CAD-Weazle/Charge-Shuttling-BMS/pics/110-BMS_test-setup.png

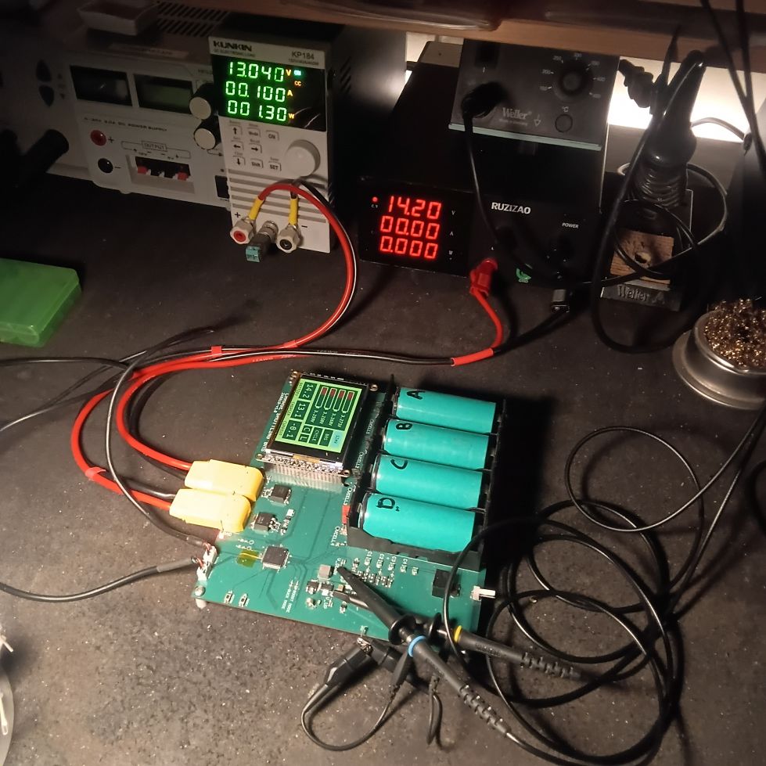
pics/110-BMS_test-setup.png
