CAD-Weazle/Charge-Shuttling-BMS/pics/48-cycle-test.png

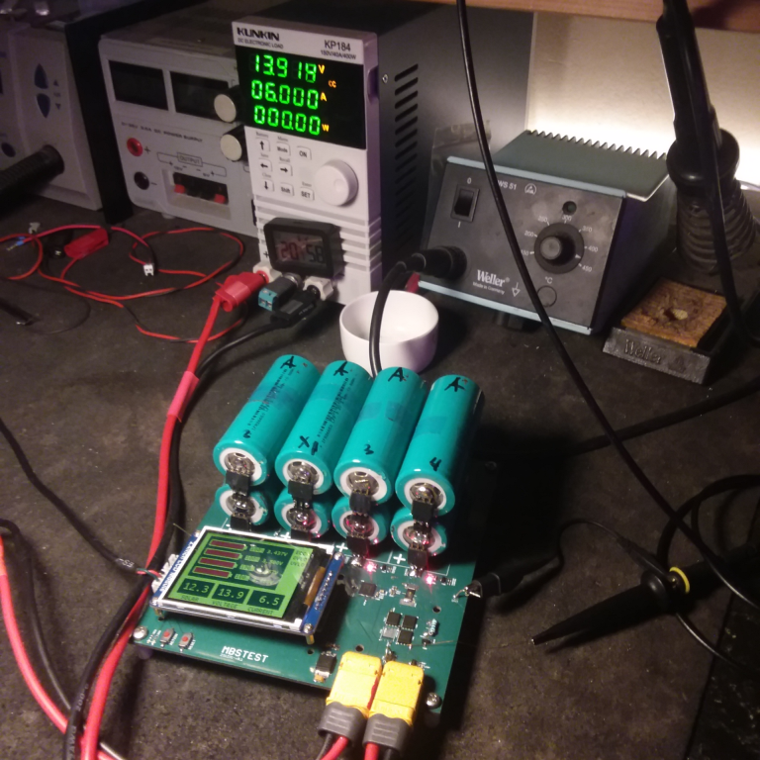
pics/48-cycle-test.png
