CAD-Weazle/Charge-Shuttling-BMS/ccode/readme.txt

Disclaimer

This project is provided "AS IS", without warranty of any kind, express or implied.

Use this software at your own risk. The author is not responsible for any damages, 
data loss, or other issues resulting from the use of this software, to the extent 
permitted by applicable law.
