CAD-Weazle/Charge-Shuttling-BMS/pics/44-LCD.png

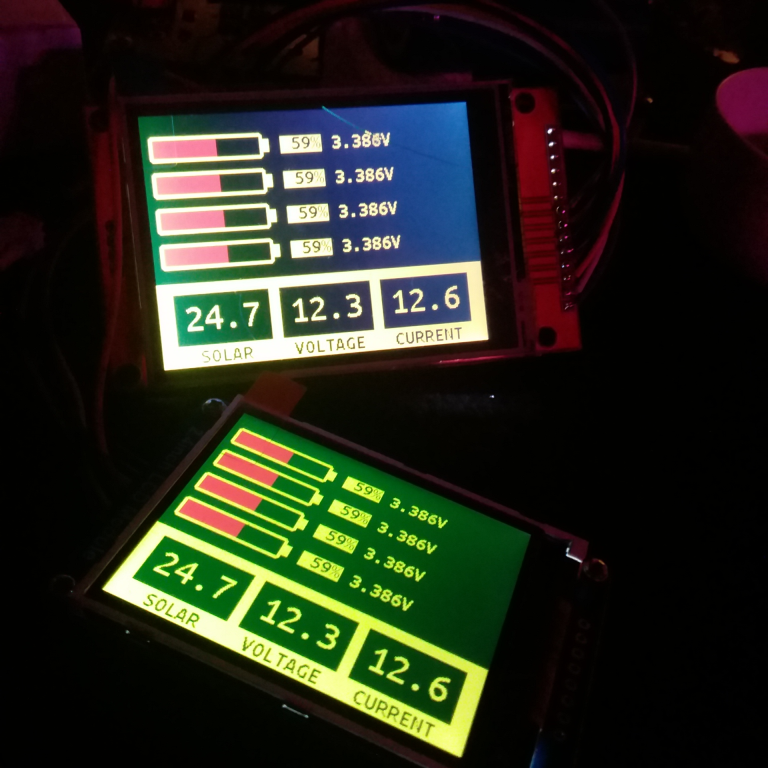
pics/44-LCD.png
