CAD-Weazle/Charge-Shuttling-BMS/pics/45-LCD.png

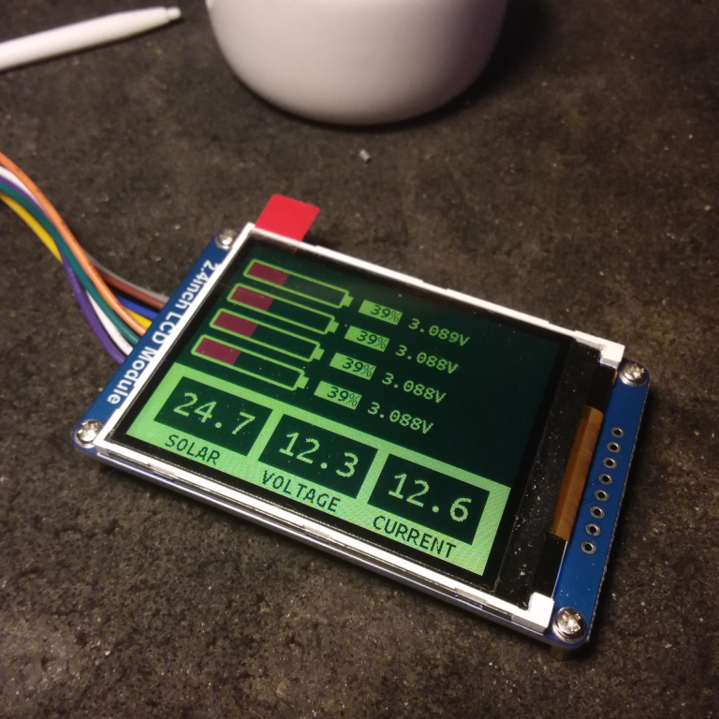
pics/45-LCD.png
