CAD-Weazle/Charge-Shuttling-BMS/pics/46-LCD-proto.png

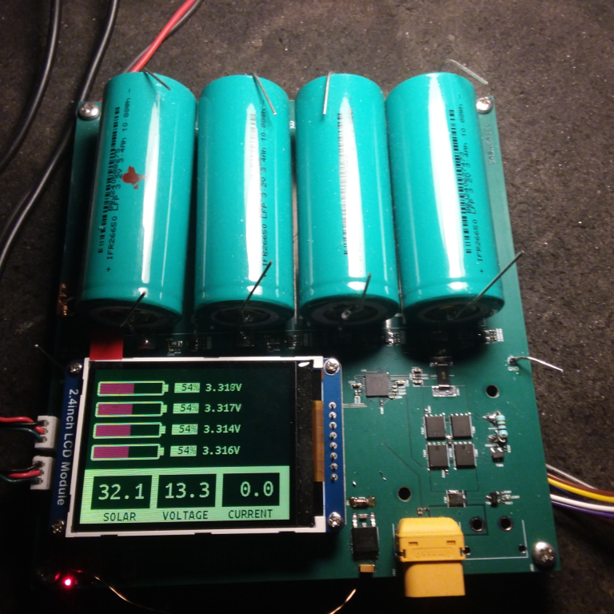
pics/46-LCD-proto.png
