CAD-Weazle/Charge-Shuttling-BMS/pics/47-V-vs-Q.png

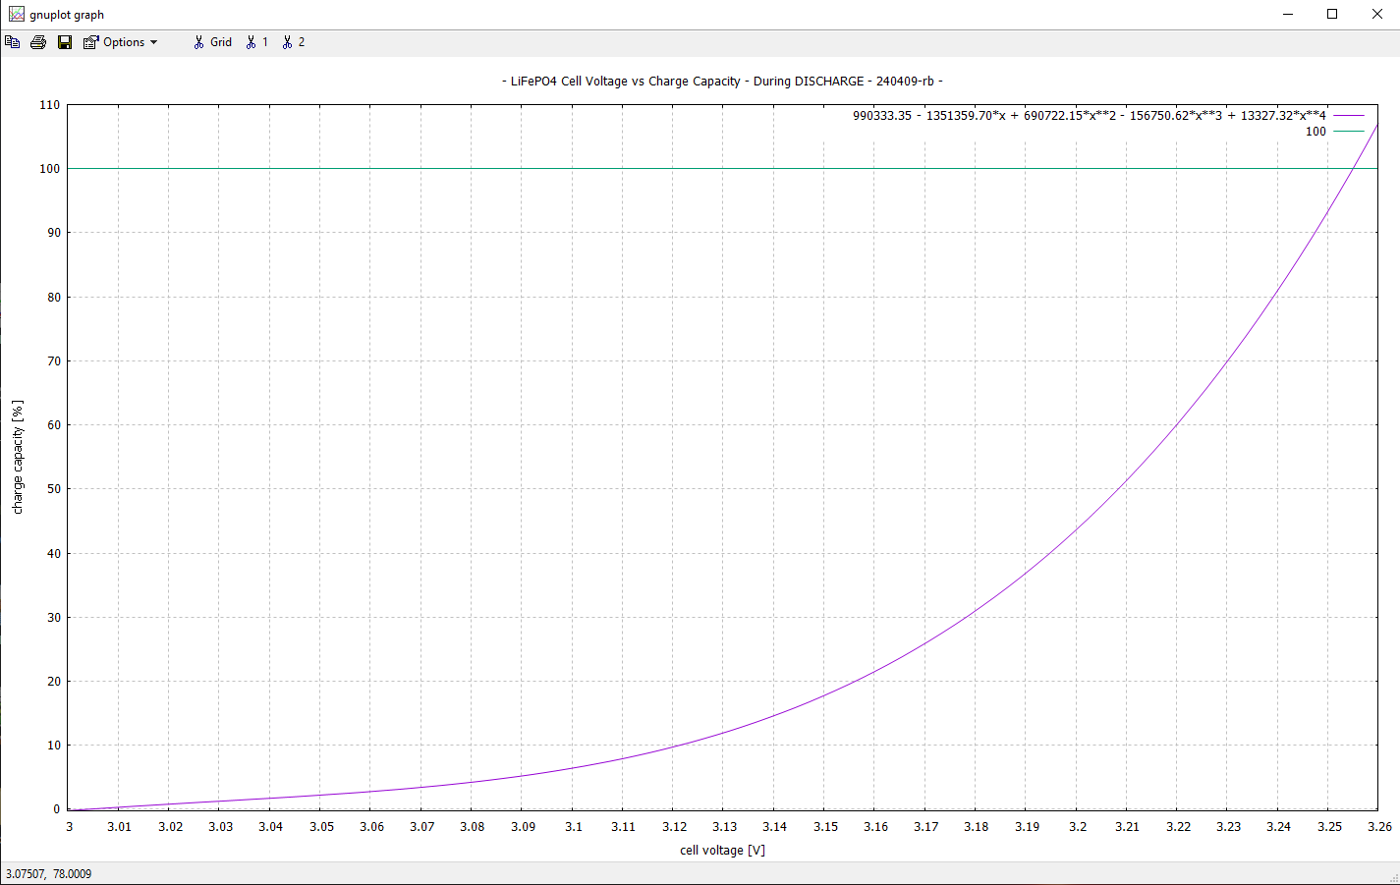
pics/47-V-vs-Q.png
