CAD-Weazle/Charge-Shuttling-BMS/pics/51-SOLBATTS.png

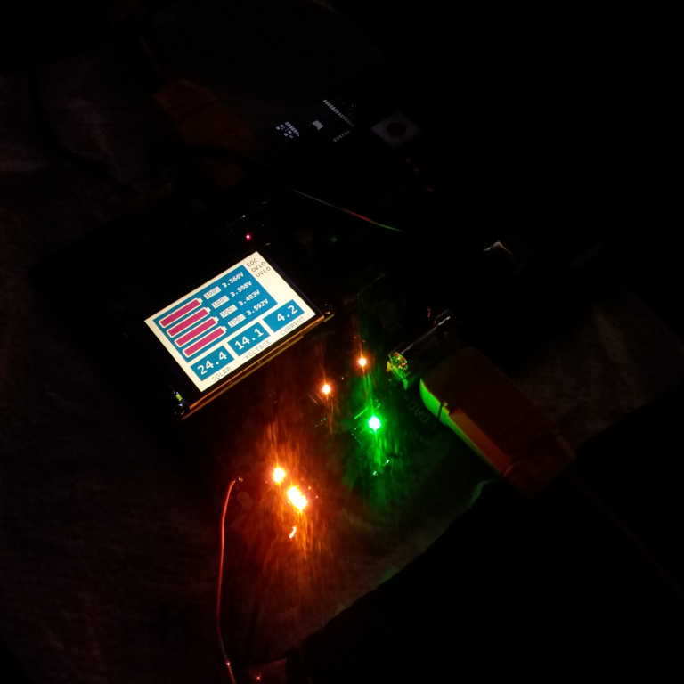
pics/51-SOLBATTS.png
