CAD-Weazle/Charge-Shuttling-BMS/pics/53-display.png

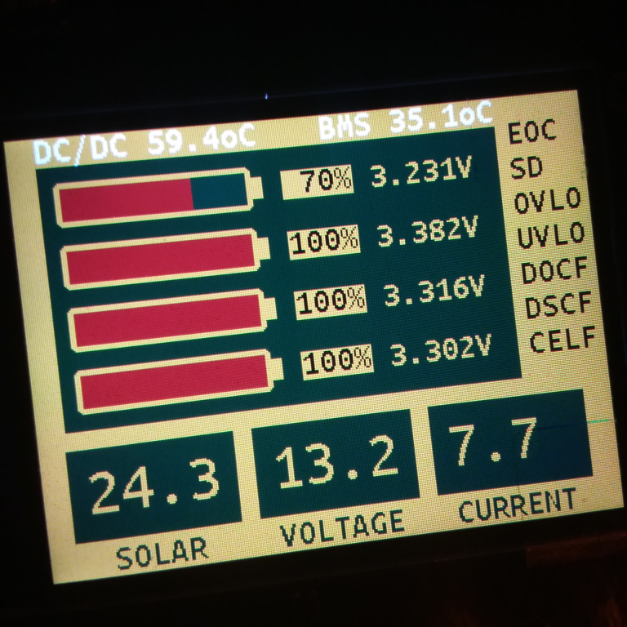
pics/53-display.png
