CAD-Weazle/Charge-Shuttling-BMS/pics/96-BMSTEST-charge-sharing.png

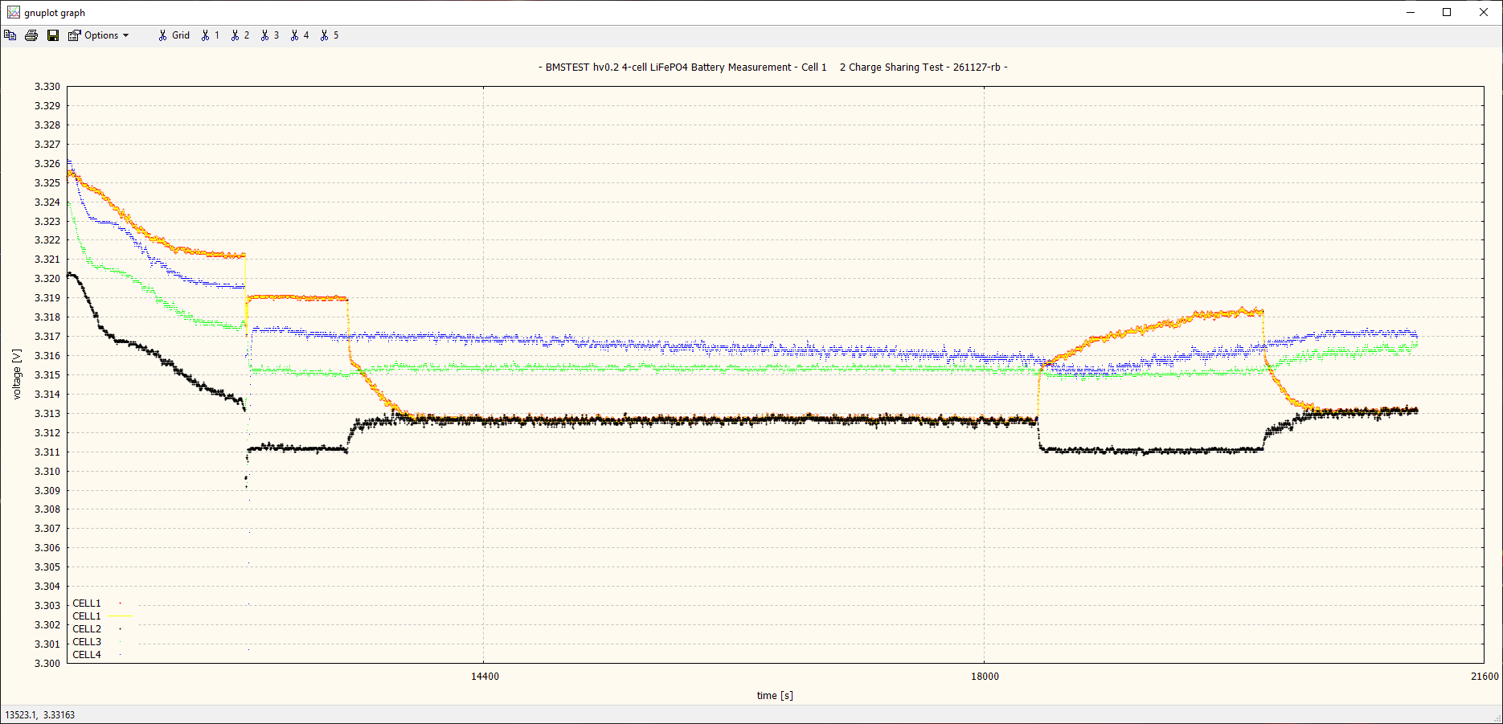
pics/96-BMSTEST-charge-sharing.png
