CAD-Weazle/Charge-Shuttling-BMS/pics/97-BMSTEST-charge-sharing.png

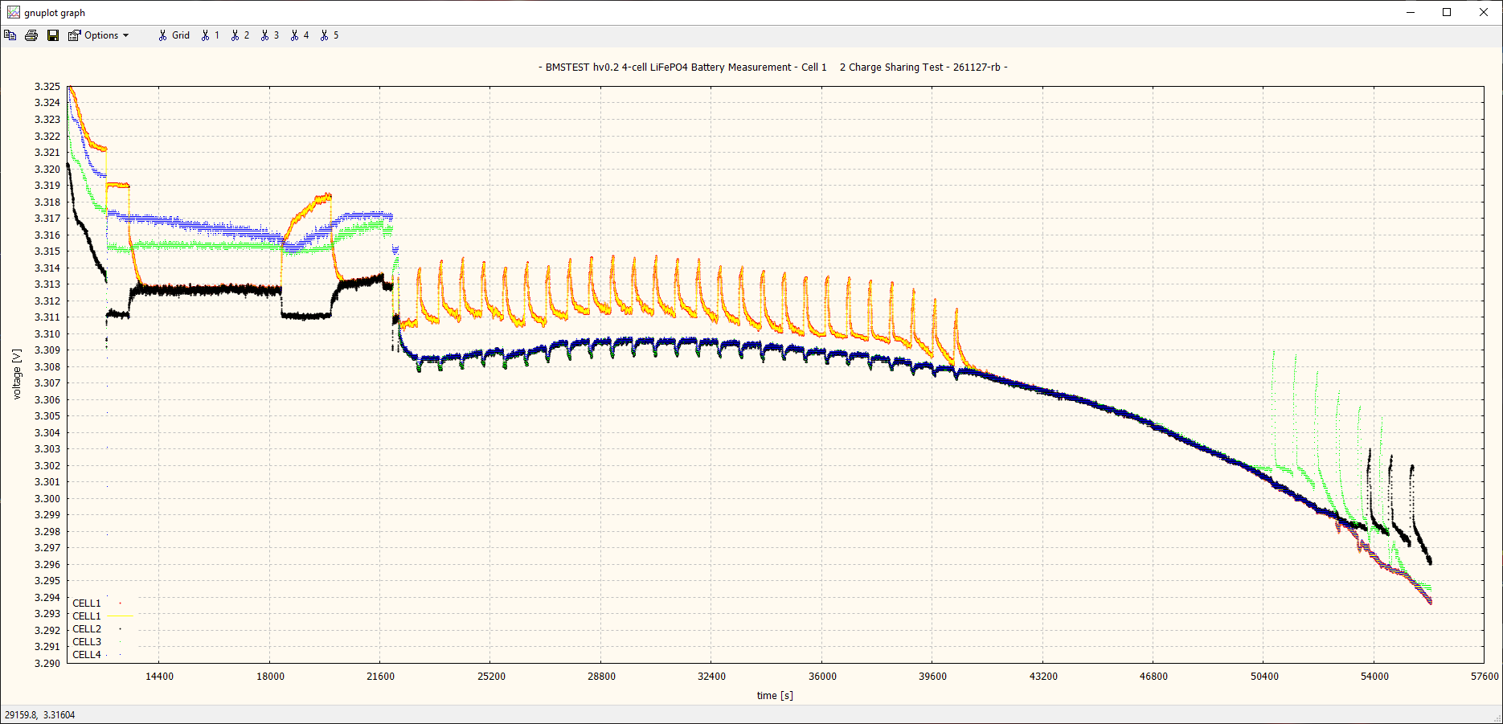
pics/97-BMSTEST-charge-sharing.png
