CAD-Weazle/Charge-Shuttling-BMS/pics/98-sharing-vs-normal.png

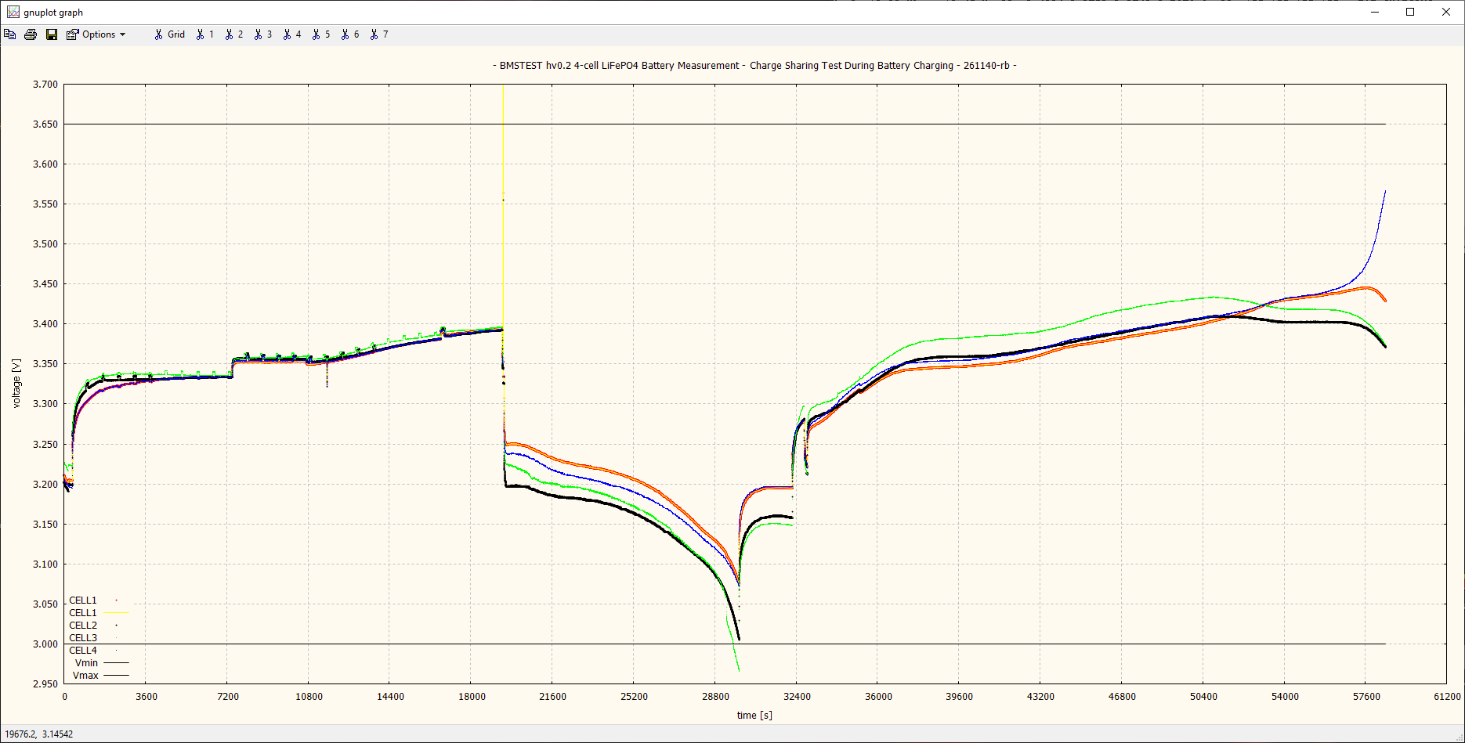
pics/98-sharing-vs-normal.png
