CAD-Weazle/Charge-Shuttling-BMS/pics/101-BMSTEST-hv0.3-PWM-noise.png

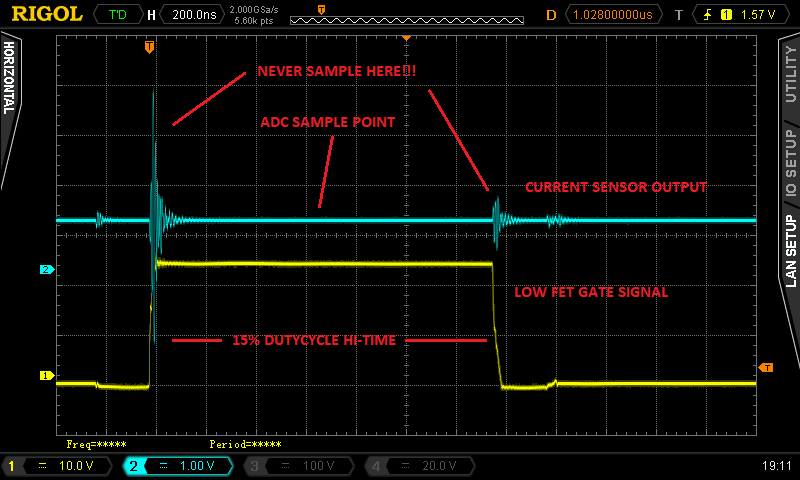
pics/101-BMSTEST-hv0.3-PWM-noise.png
