CAD-Weazle/Charge-Shuttling-BMS/pics/102-buck-boost_charge-transfer.png

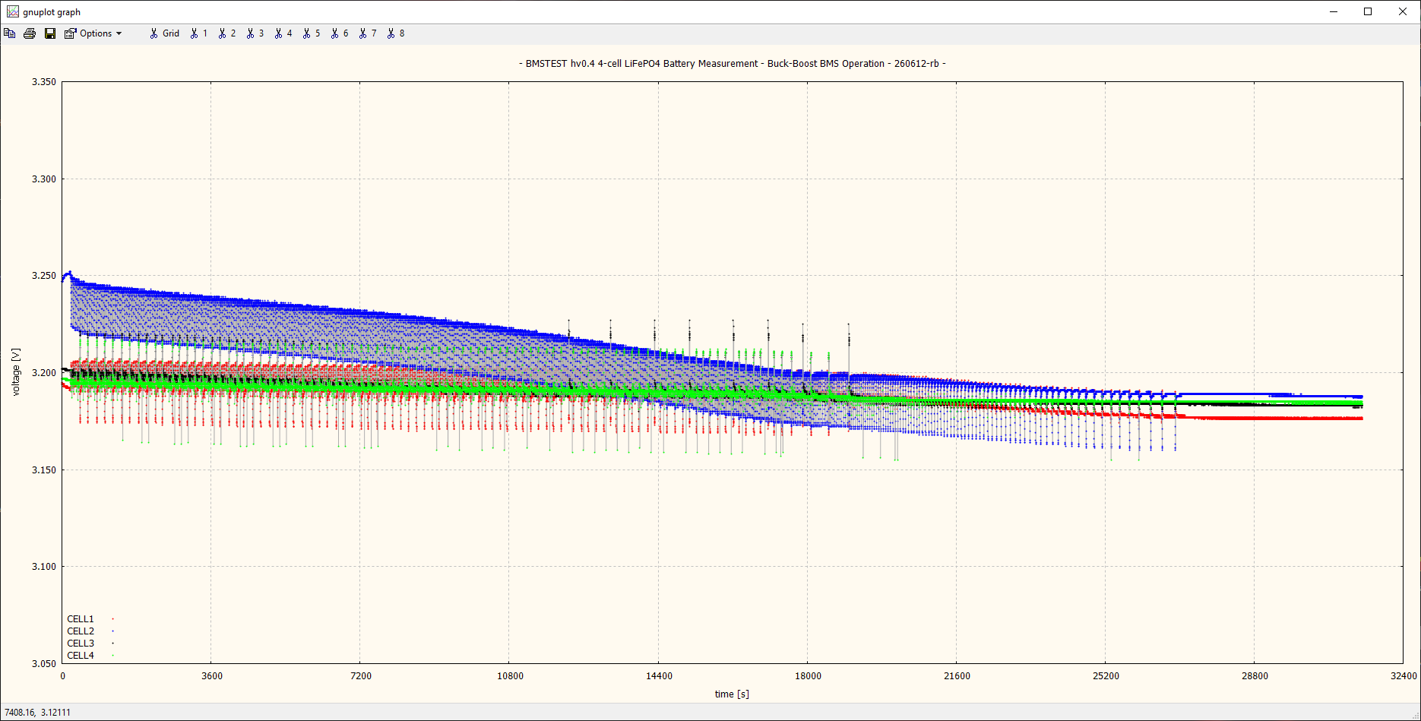
pics/102-buck-boost_charge-transfer.png
