CAD-Weazle/Charge-Shuttling-BMS/pics/102-diff-amp-noise.png

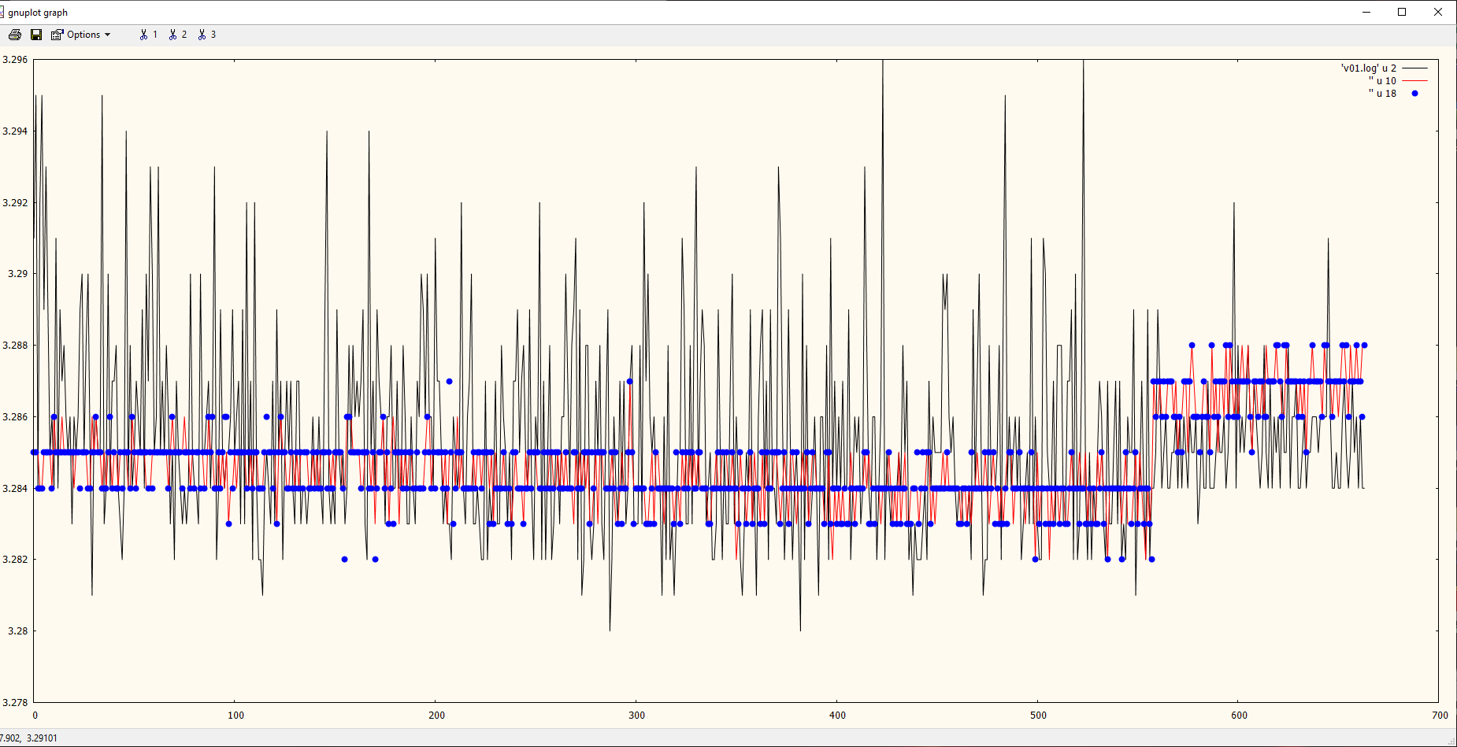
pics/102-diff-amp-noise.png
