CAD-Weazle/Charge-Shuttling-BMS/pics/103-balancing-after-charging.png

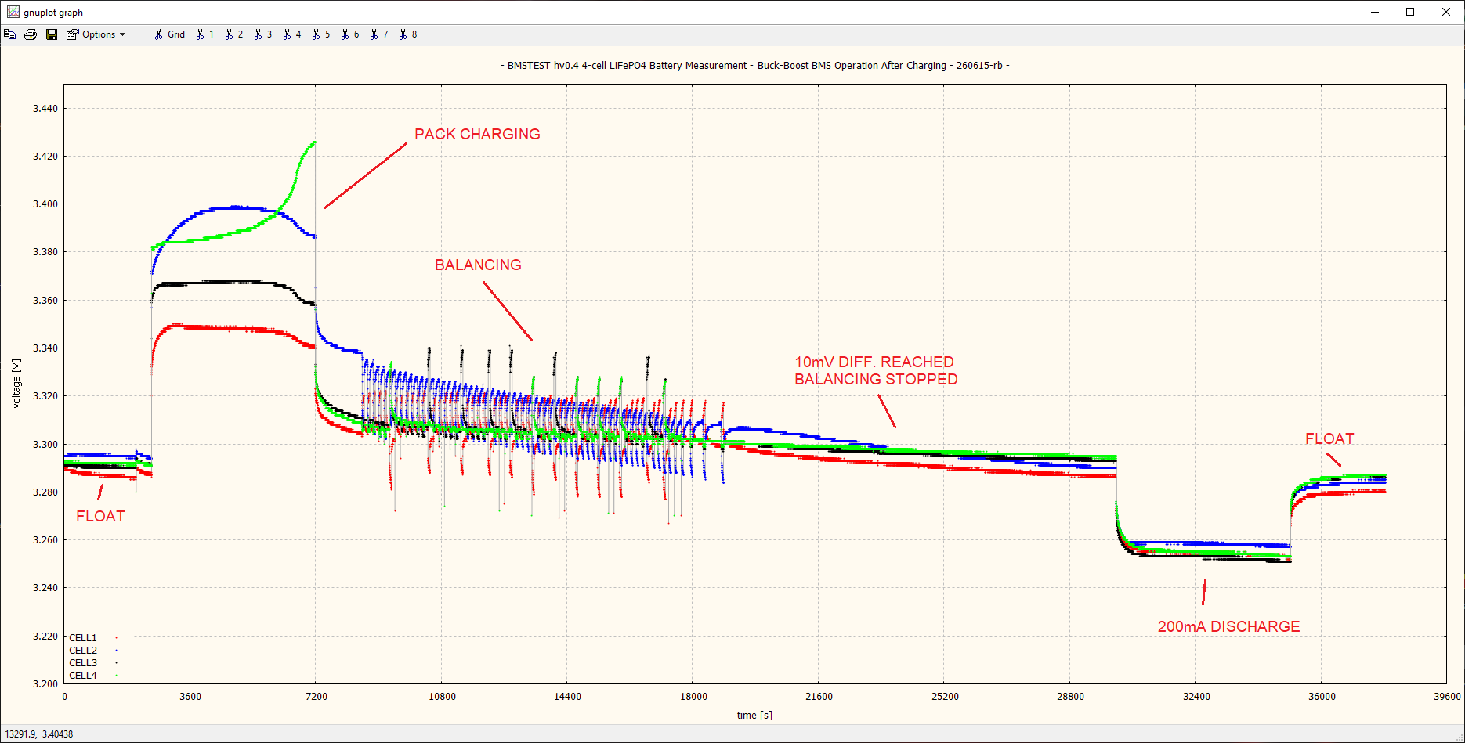
pics/103-balancing-after-charging.png
