CAD-Weazle/Charge-Shuttling-BMS/pics/104-balancing.png

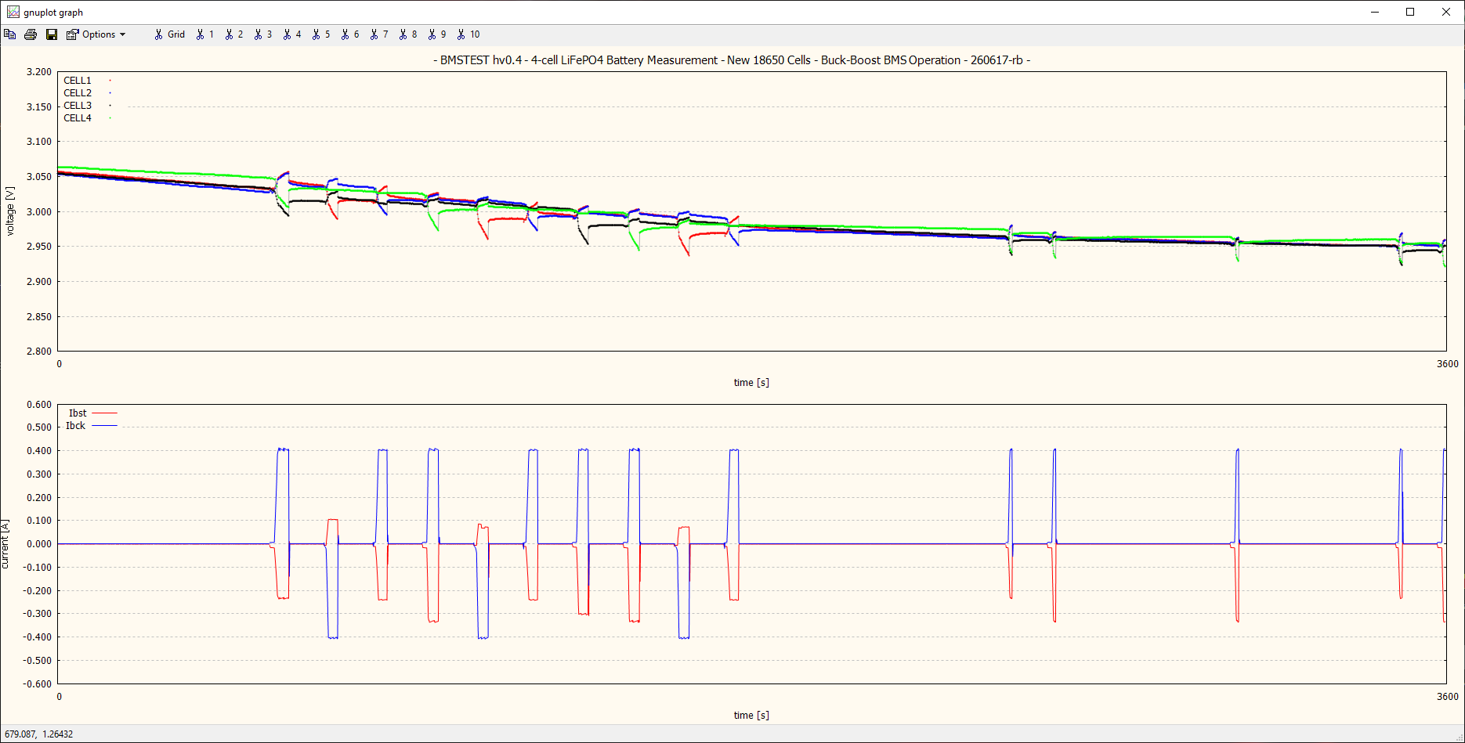
pics/104-balancing.png
