CAD-Weazle/Charge-Shuttling-BMS/pics/105-pass-FET-matrix.png

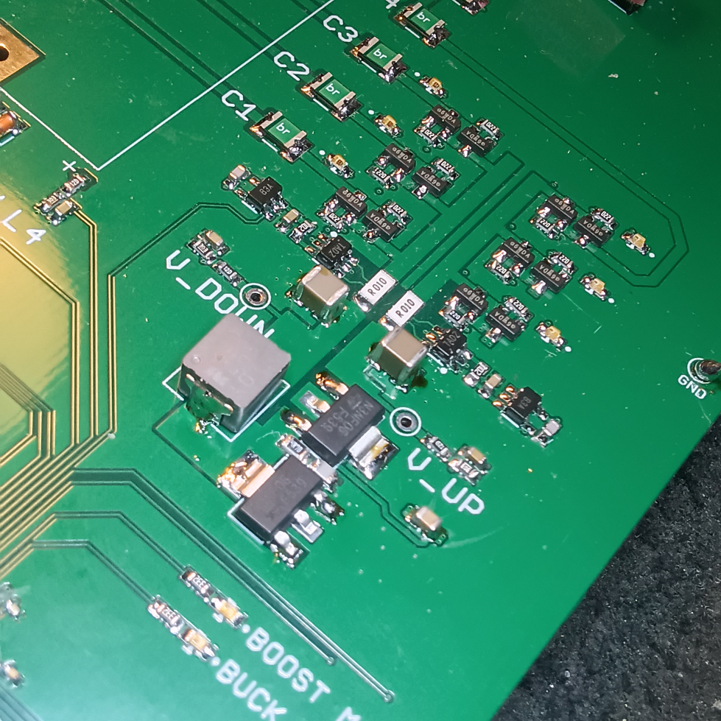
pics/105-pass-FET-matrix.png
