CAD-Weazle/Charge-Shuttling-BMS/pics/106-display.png

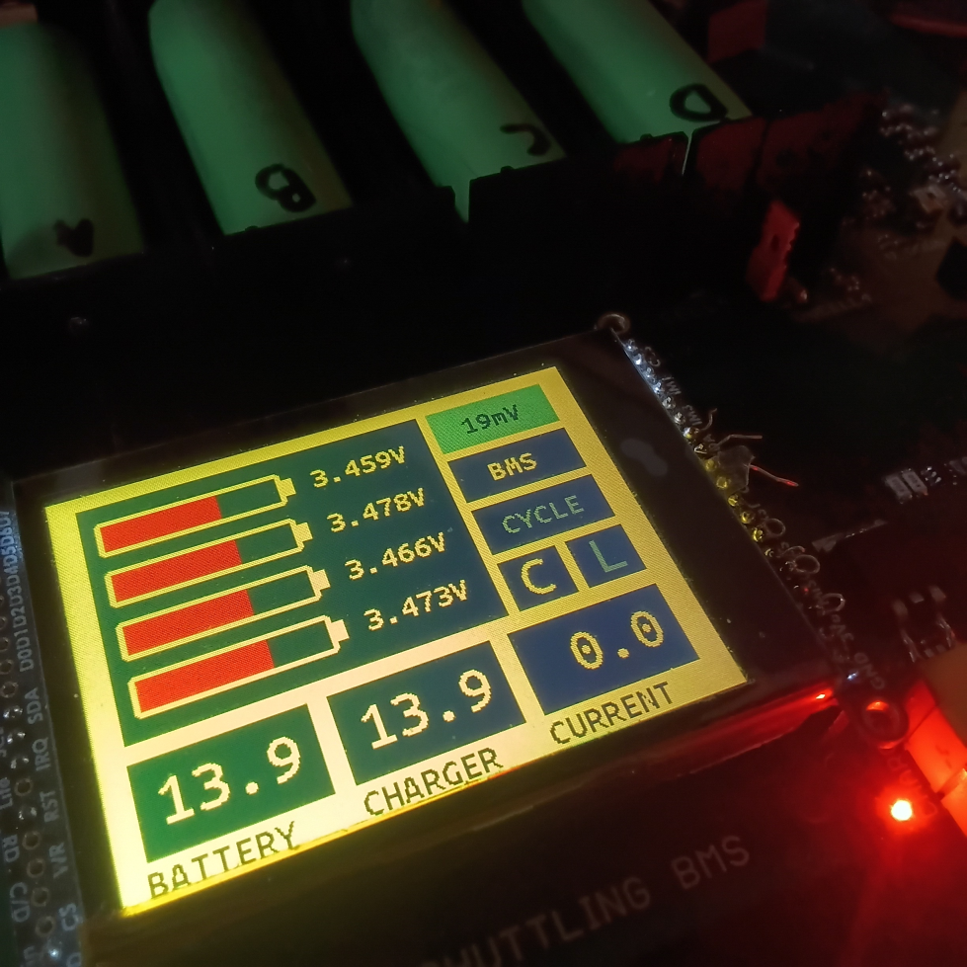
pics/106-display.png
