CAD-Weazle/Charge-Shuttling-BMS/pics/109-BMS-action.png

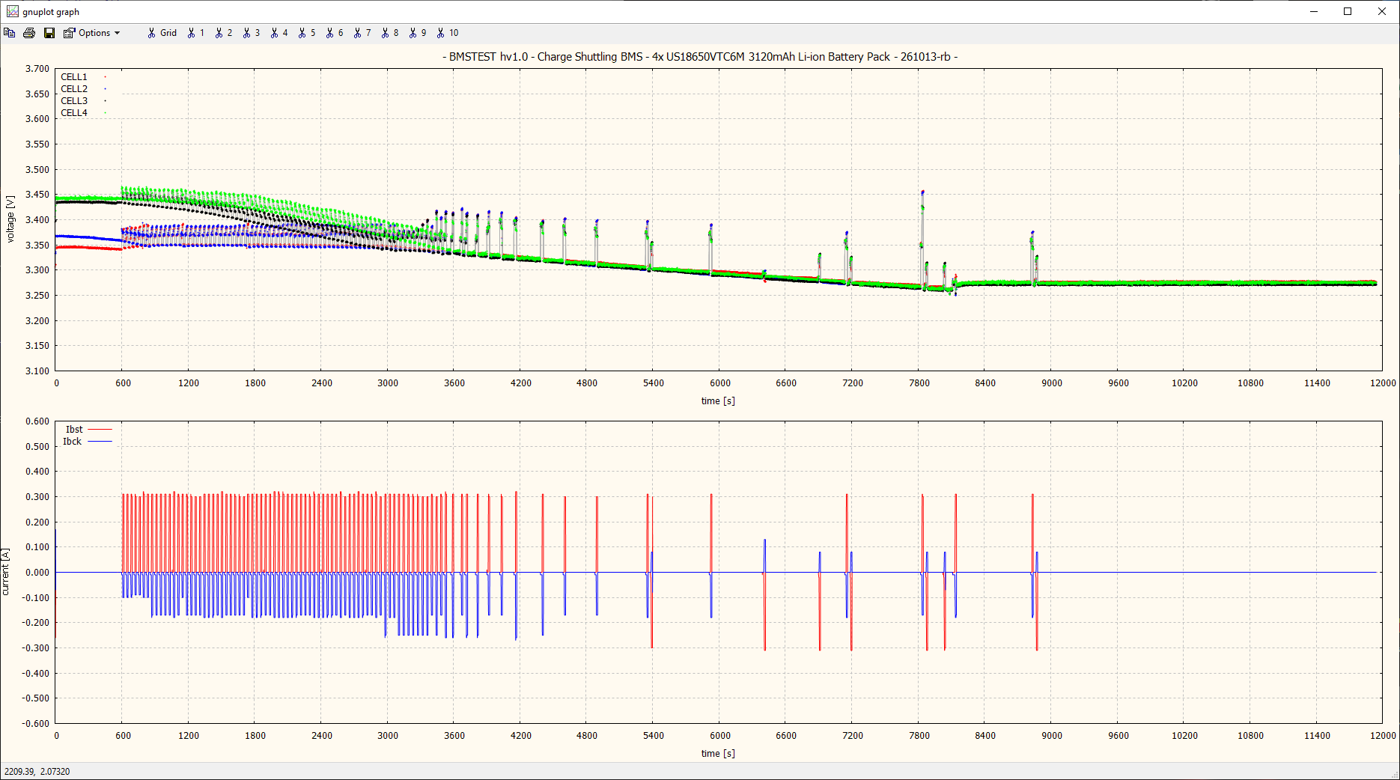
pics/109-BMS-action.png
