CAD-Weazle/Charge-Shuttling-BMS/pics/111-prtscr.png

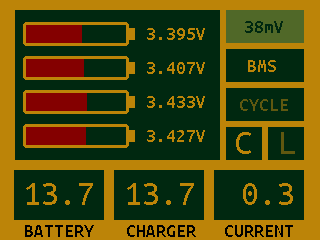
pics/111-prtscr.png
