CAD-Weazle/Charge-Shuttling-BMS/pics/113-BMSTEST.png

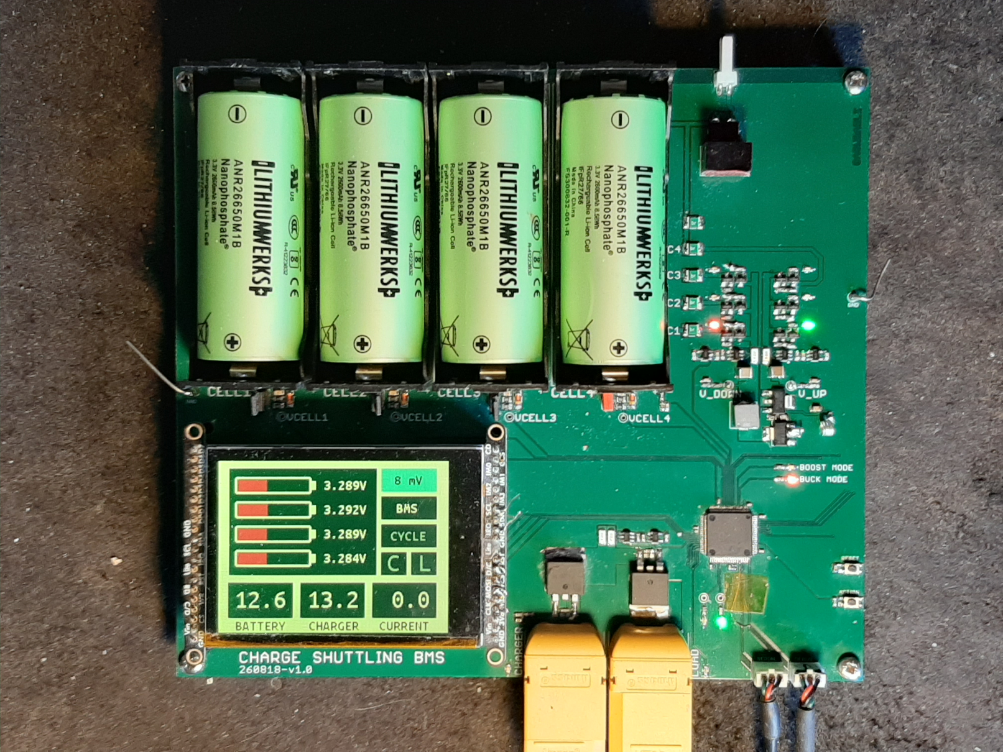
pics/113-BMSTEST.png
