CAD-Weazle/Charge-Shuttling-BMS/pics/114-pass-FET_matrix.png

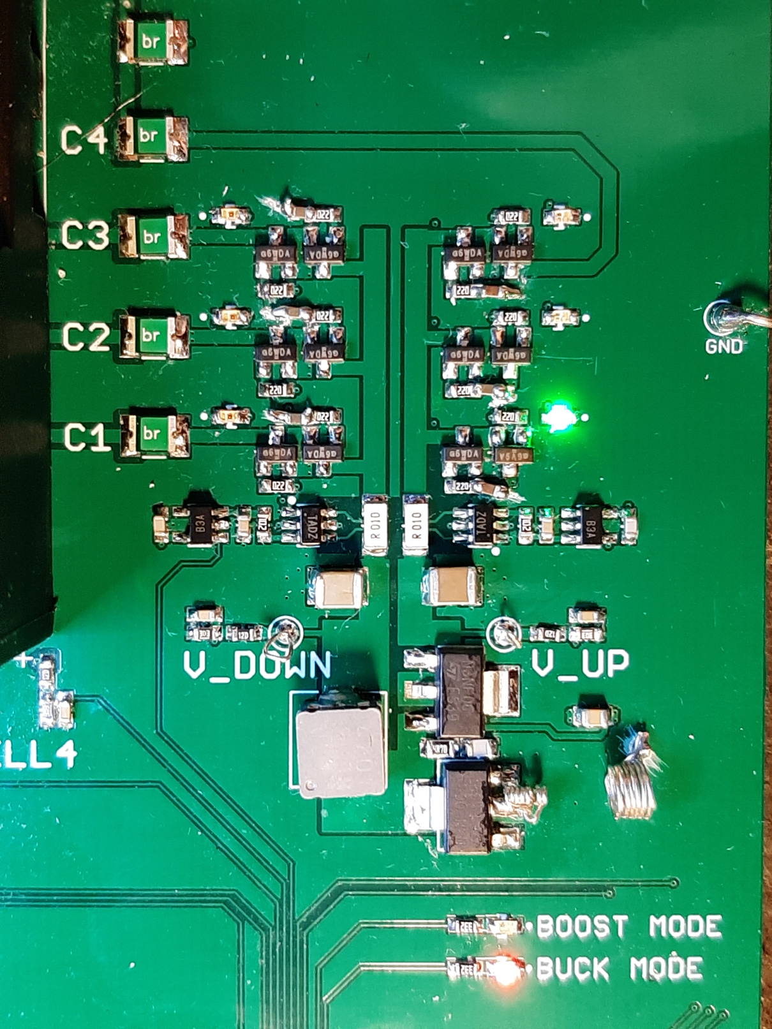
pics/114-pass-FET_matrix.png
