CAD-Weazle/Charge-Shuttling-BMS/pics/117-balancing_A123.png

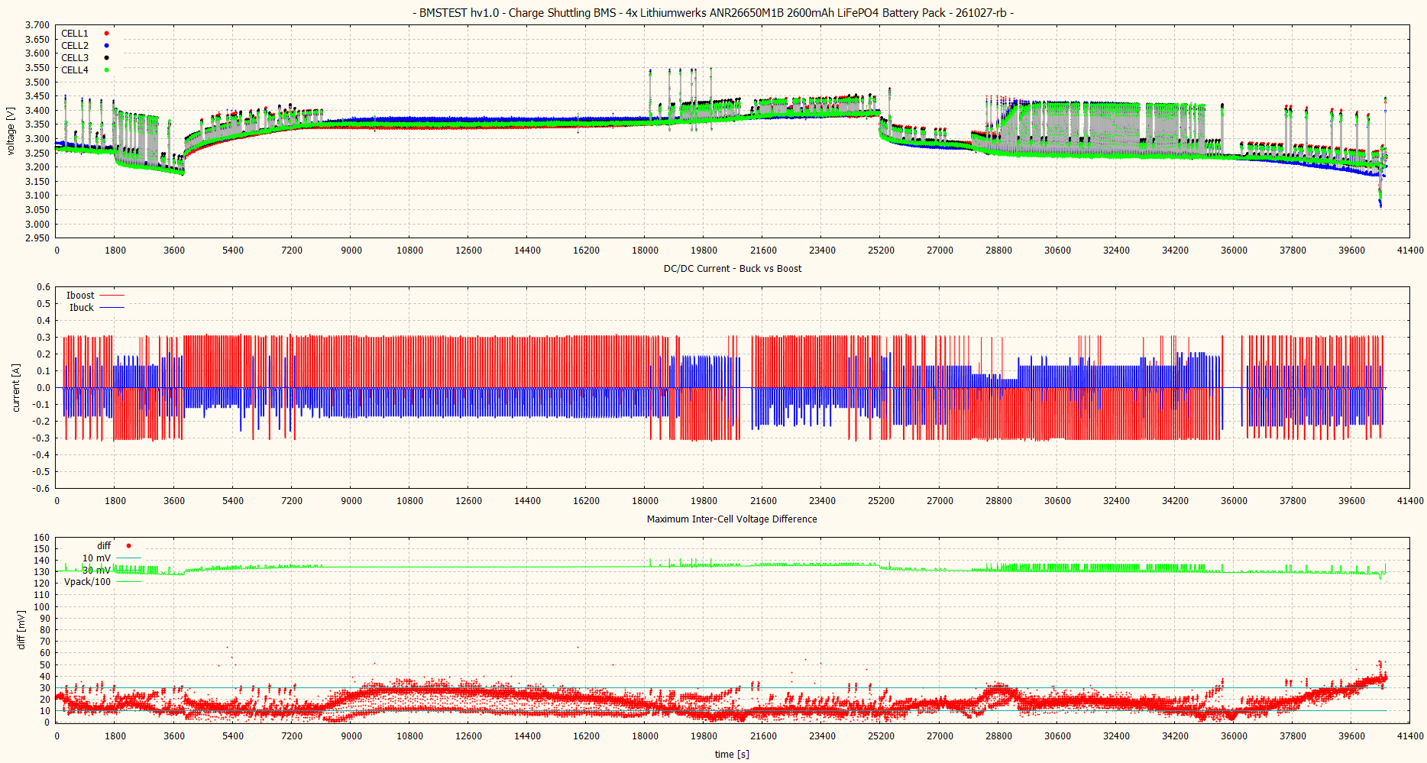
pics/117-balancing_A123.png
