CAD-Weazle/Charge-Shuttling-BMS/pics/118-cycling_A123.png

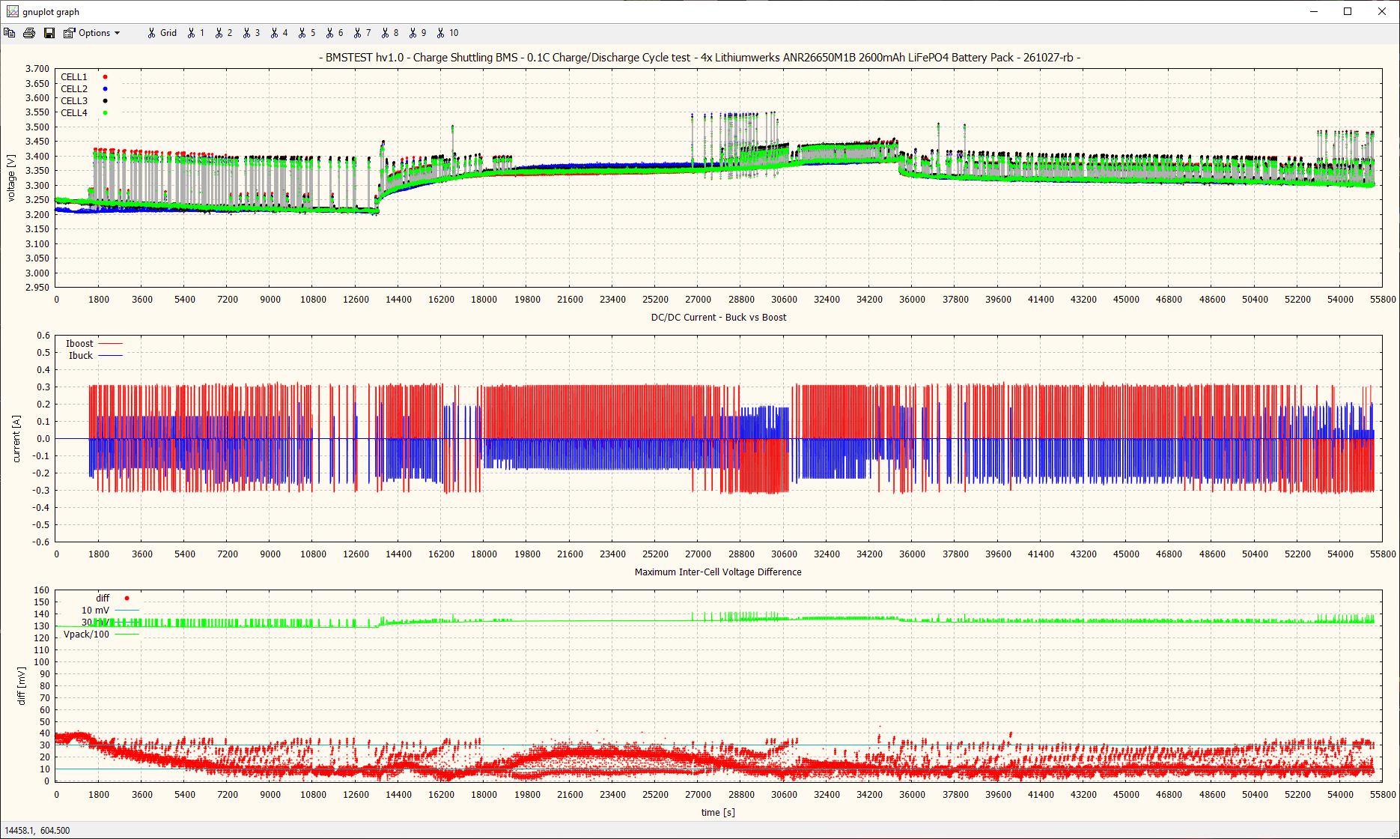
pics/118-cycling_A123.png
