CAD-Weazle/Charge-Shuttling-BMS/pics/119-serial-CLI.png

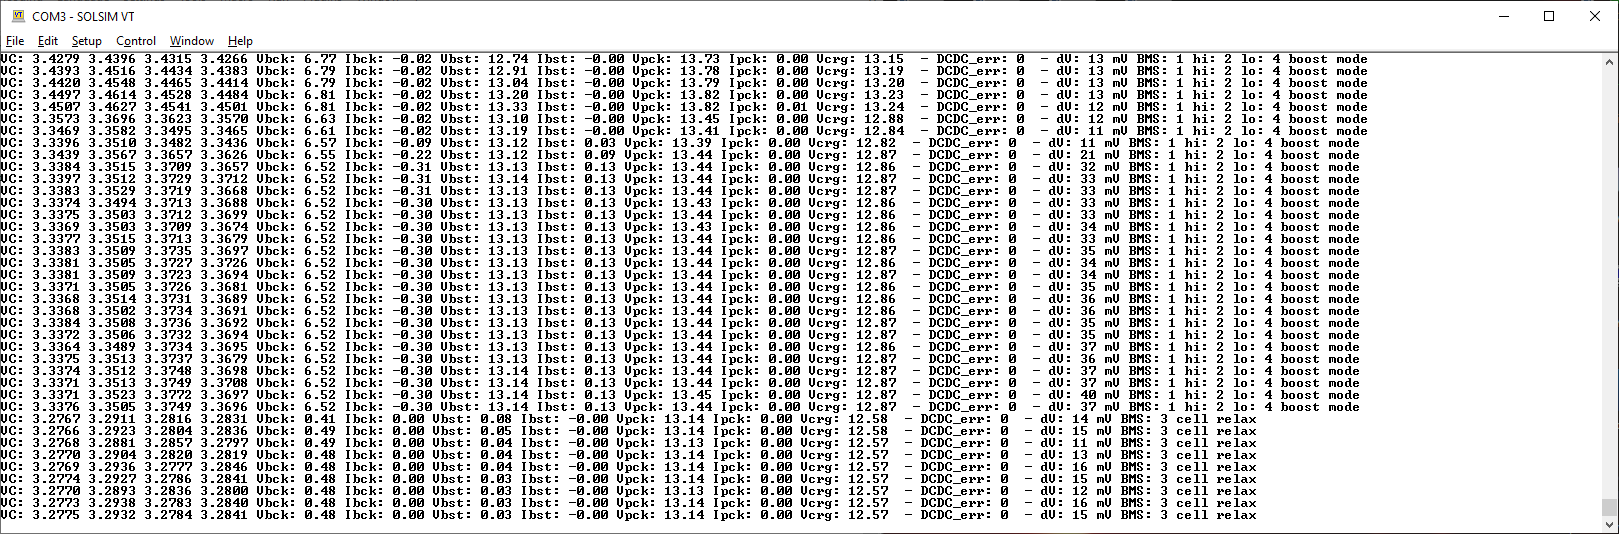
pics/119-serial-CLI.png
