CAD-Weazle/Charge-Shuttling-BMS/pics/unbuf-vs-buf.png

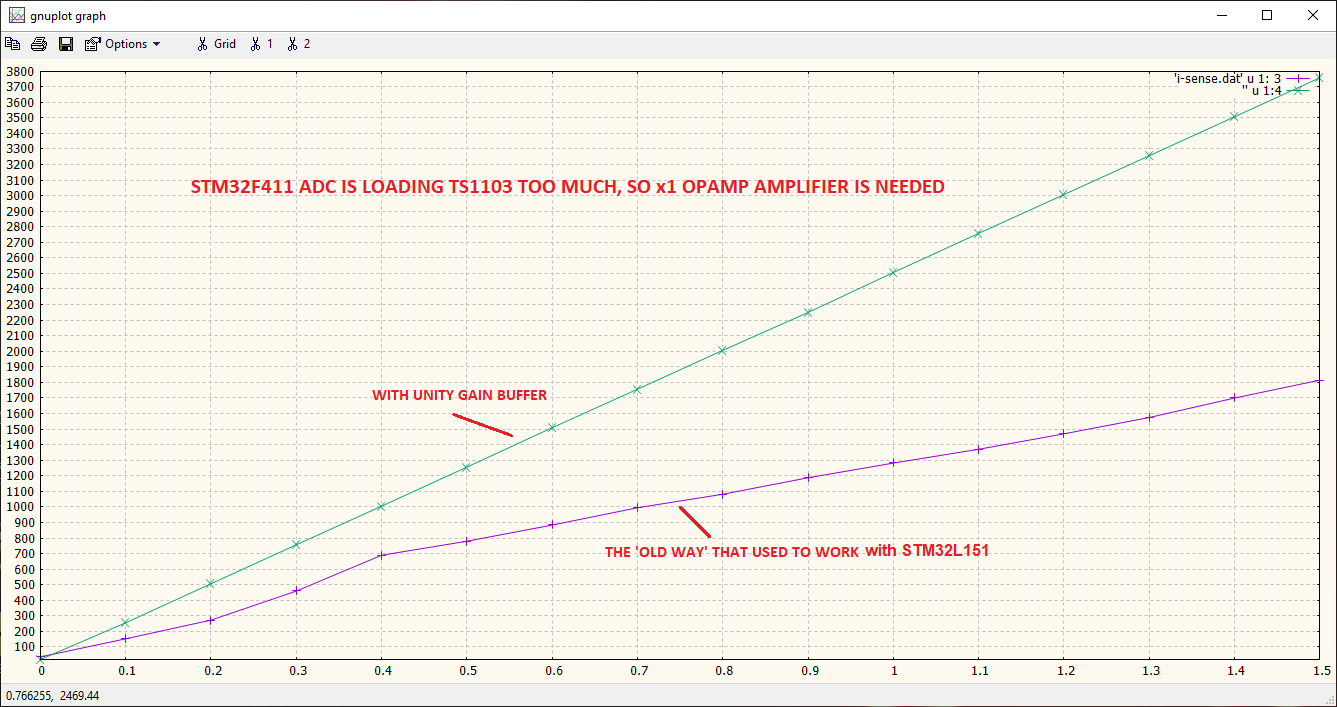
pics/unbuf-vs-buf.png
