CAD-Weazle/Charge-Shuttling-BMS/pics/107-small-cell_cycle-test.png

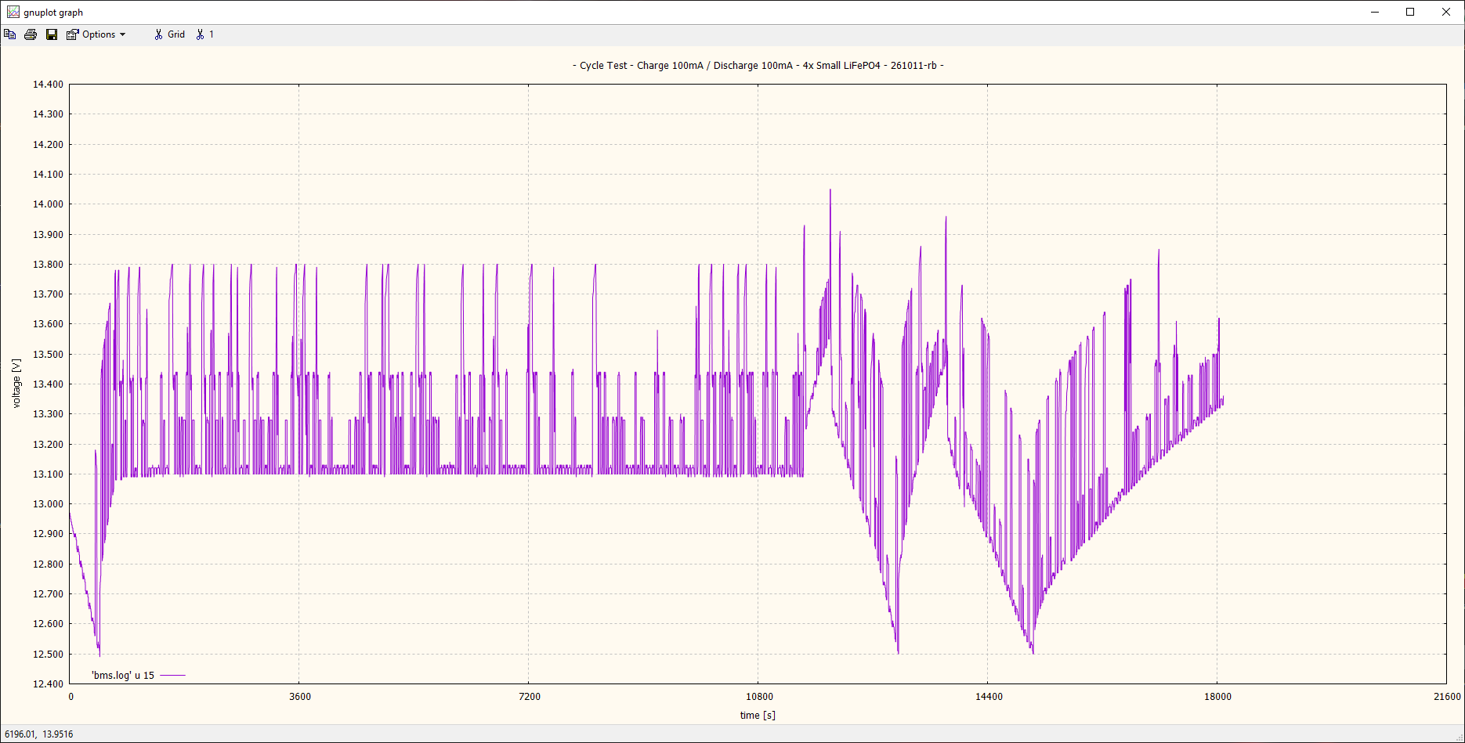
pics/107-small-cell_cycle-test.png
