CAD-Weazle/Charge-Shuttling-BMS/pics/108-small-cell_cycle-test.png

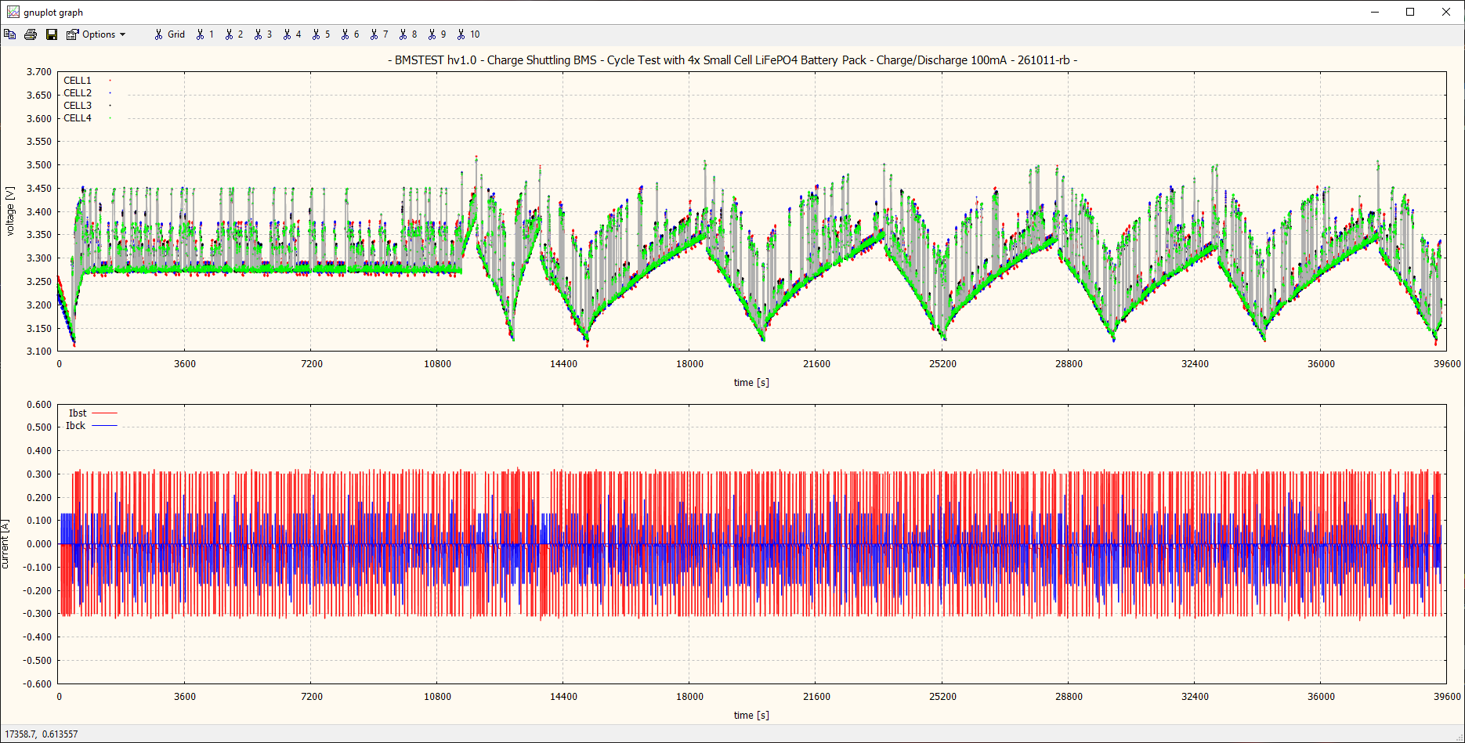
pics/108-small-cell_cycle-test.png
