CAD-Weazle/Charge-Shuttling-BMS/pics/115-balancing_test.png

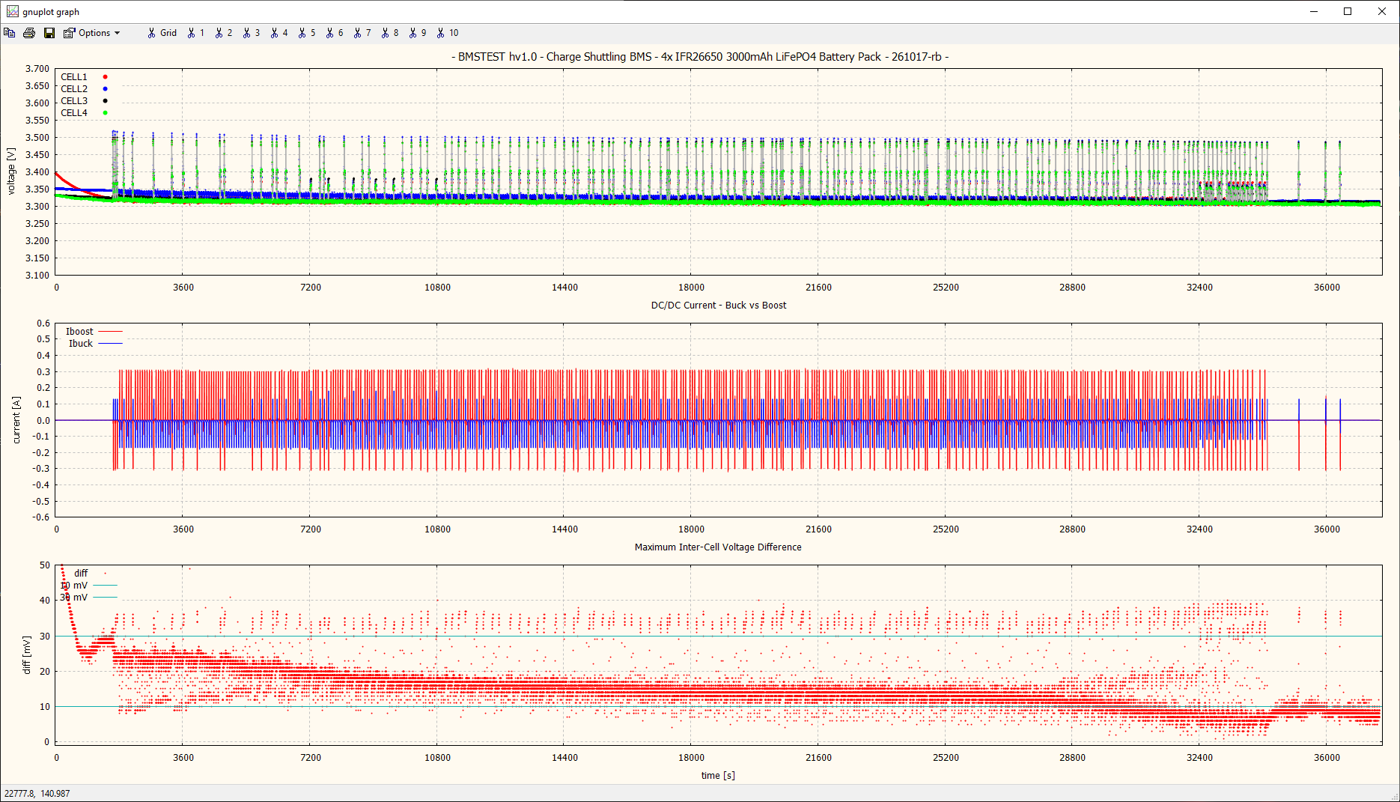
pics/115-balancing_test.png
