CAD-Weazle/Charge-Shuttling-BMS/pics/116-balancing_test.png

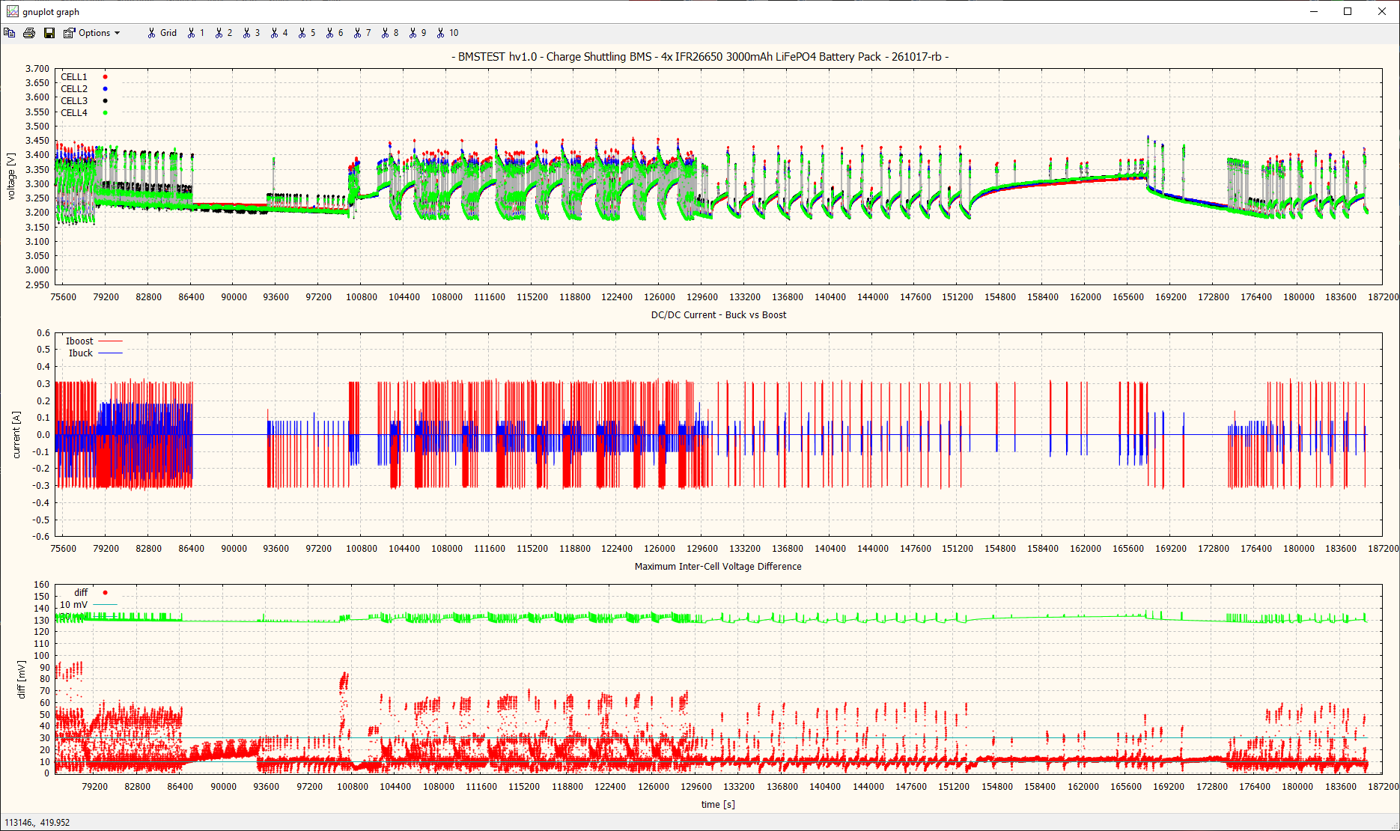
pics/116-balancing_test.png
