CAD-Weazle/Charge-Shuttling-BMS/pics/120-perturb-test.png

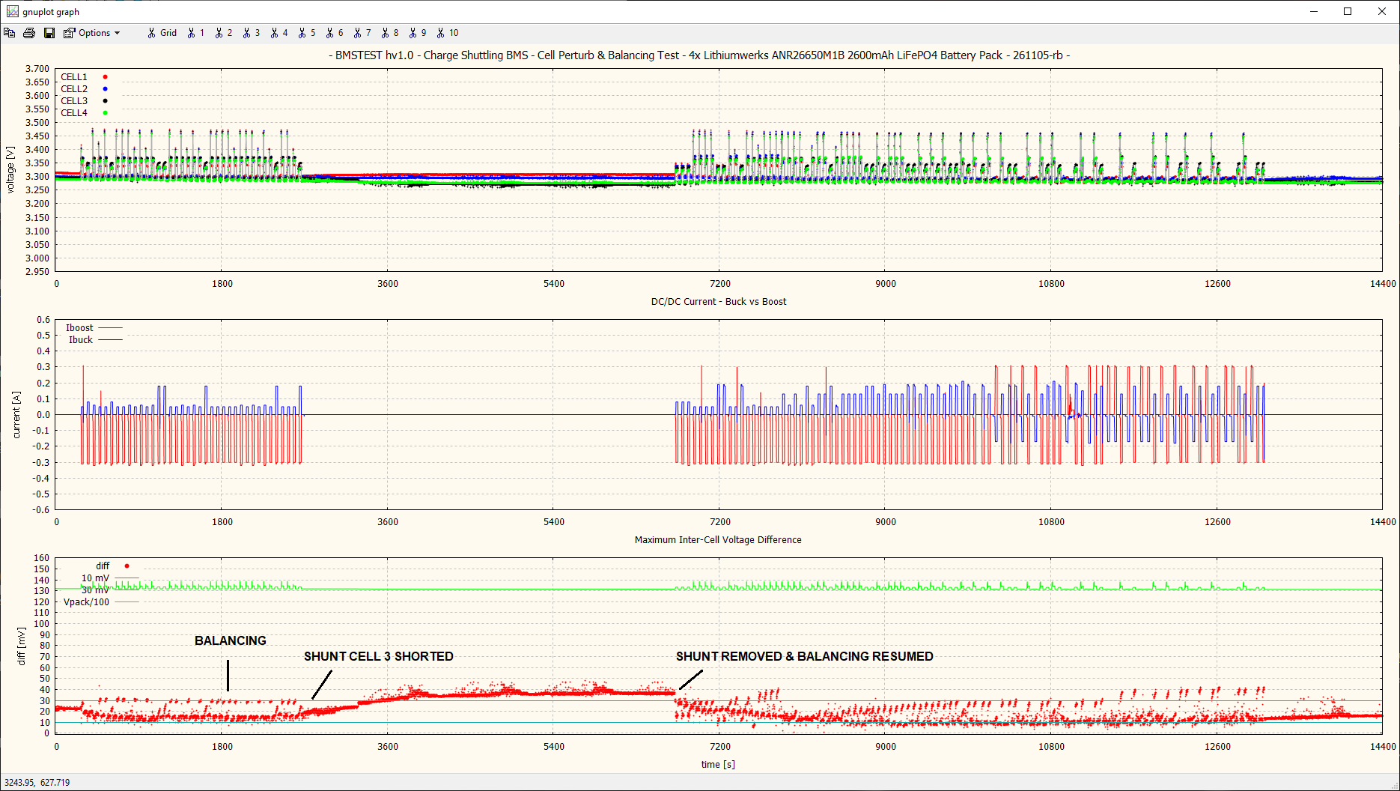
pics/120-perturb-test.png
