CAD-Weazle/Charge-Shuttling-BMS/eagle/BMSTEST-v1.1.brd

## EAGLE design eagle/BMSTEST-v1.1.brd (2026-11-05)

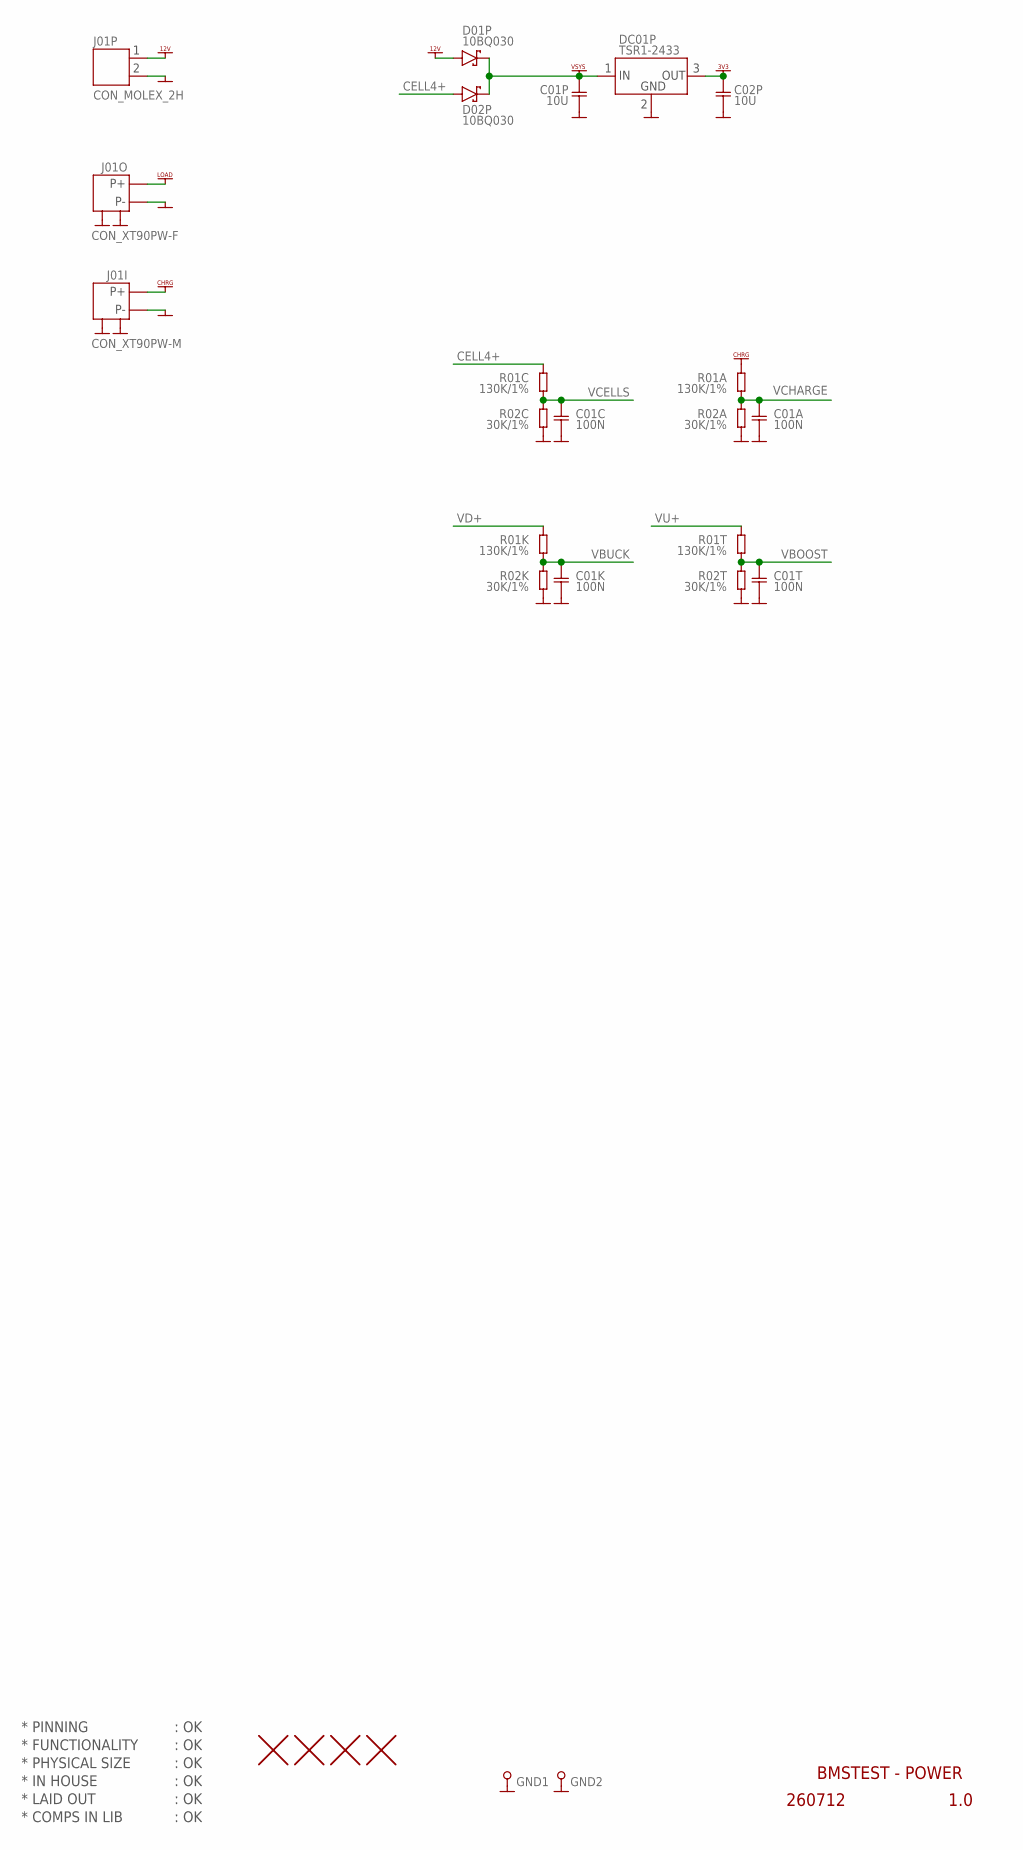
[picture p32: schematic BMSTEST-v1.1.sch, sheet 1]

Parts:
C01A, C01C: 100N; CAP0805
C01K, C01T: 100N; CAP0603
C01P, C02P: 10U; CAP0805
D01P, D02P: 10BQ030; DIODE_SMB
DC01P: TSR1-2433
GND1, GND2: PIN_TEST; HOLE_PTH_0.8MM
H1, H2, H3, H4: HOLE_NPTH_3.2MM
J01I: CON_XT90PW-M
J01O: CON_XT90PW-F
J01P: CON_MOLEX_2H
R01A, R01C: 130K/1%; RES0805
R01K, R01T: 130K/1%; RES0603
R02A, R02C: 30K/1%; RES0805
R02K, R02T: 30K/1%; RES0603

Connections:
CELL4+: D02P.A (+), R01C.2; also elsewhere on the board
GND: C01A.2, C01C.2, C01K.2, C01P.2, C01T.2, C02P.2, DC01P.2 (2.GND), GND1.1, GND2.1, J01I.-, J01I.CASE1, J01I.CASE2, J01O.-, J01O.CASE1, J01O.CASE2, J01P.2, R02A.1, R02C.1, R02K.1, R02T.1; also elsewhere on the board
VBOOST: C01T.1, R01T.1, R02T.2; also elsewhere on the board
VBUCK: C01K.1, R01K.1, R02K.2; also elsewhere on the board
VCELLS: C01C.1, R01C.1, R02C.2; also elsewhere on the board
VCHARGE: C01A.1, R01A.1, R02A.2; also elsewhere on the board
VD+: R01K.2; also elsewhere on the board
VDD_3V3: C02P.1, DC01P.3 (3.OUT); also elsewhere on the board
VDD_12V: D01P.A (+), J01P.1
VSYS: C01P.1, D01P.C (-), D02P.C (-), DC01P.1 (1.IN); also elsewhere on the board
VU+: R01T.2; also elsewhere on the board
V_CHARGER: J01I.+, R01A.2; also elsewhere on the board
V_LOAD: J01O.+; also elsewhere on the board

Notes on the sheet:
* PINNING
* FUNCTIONALITY
* PHYSICAL SIZE
* LAID OUT
* COMPS IN LIB
* IN HOUSE
BMSTEST - POWER
260712
1.0
: OK

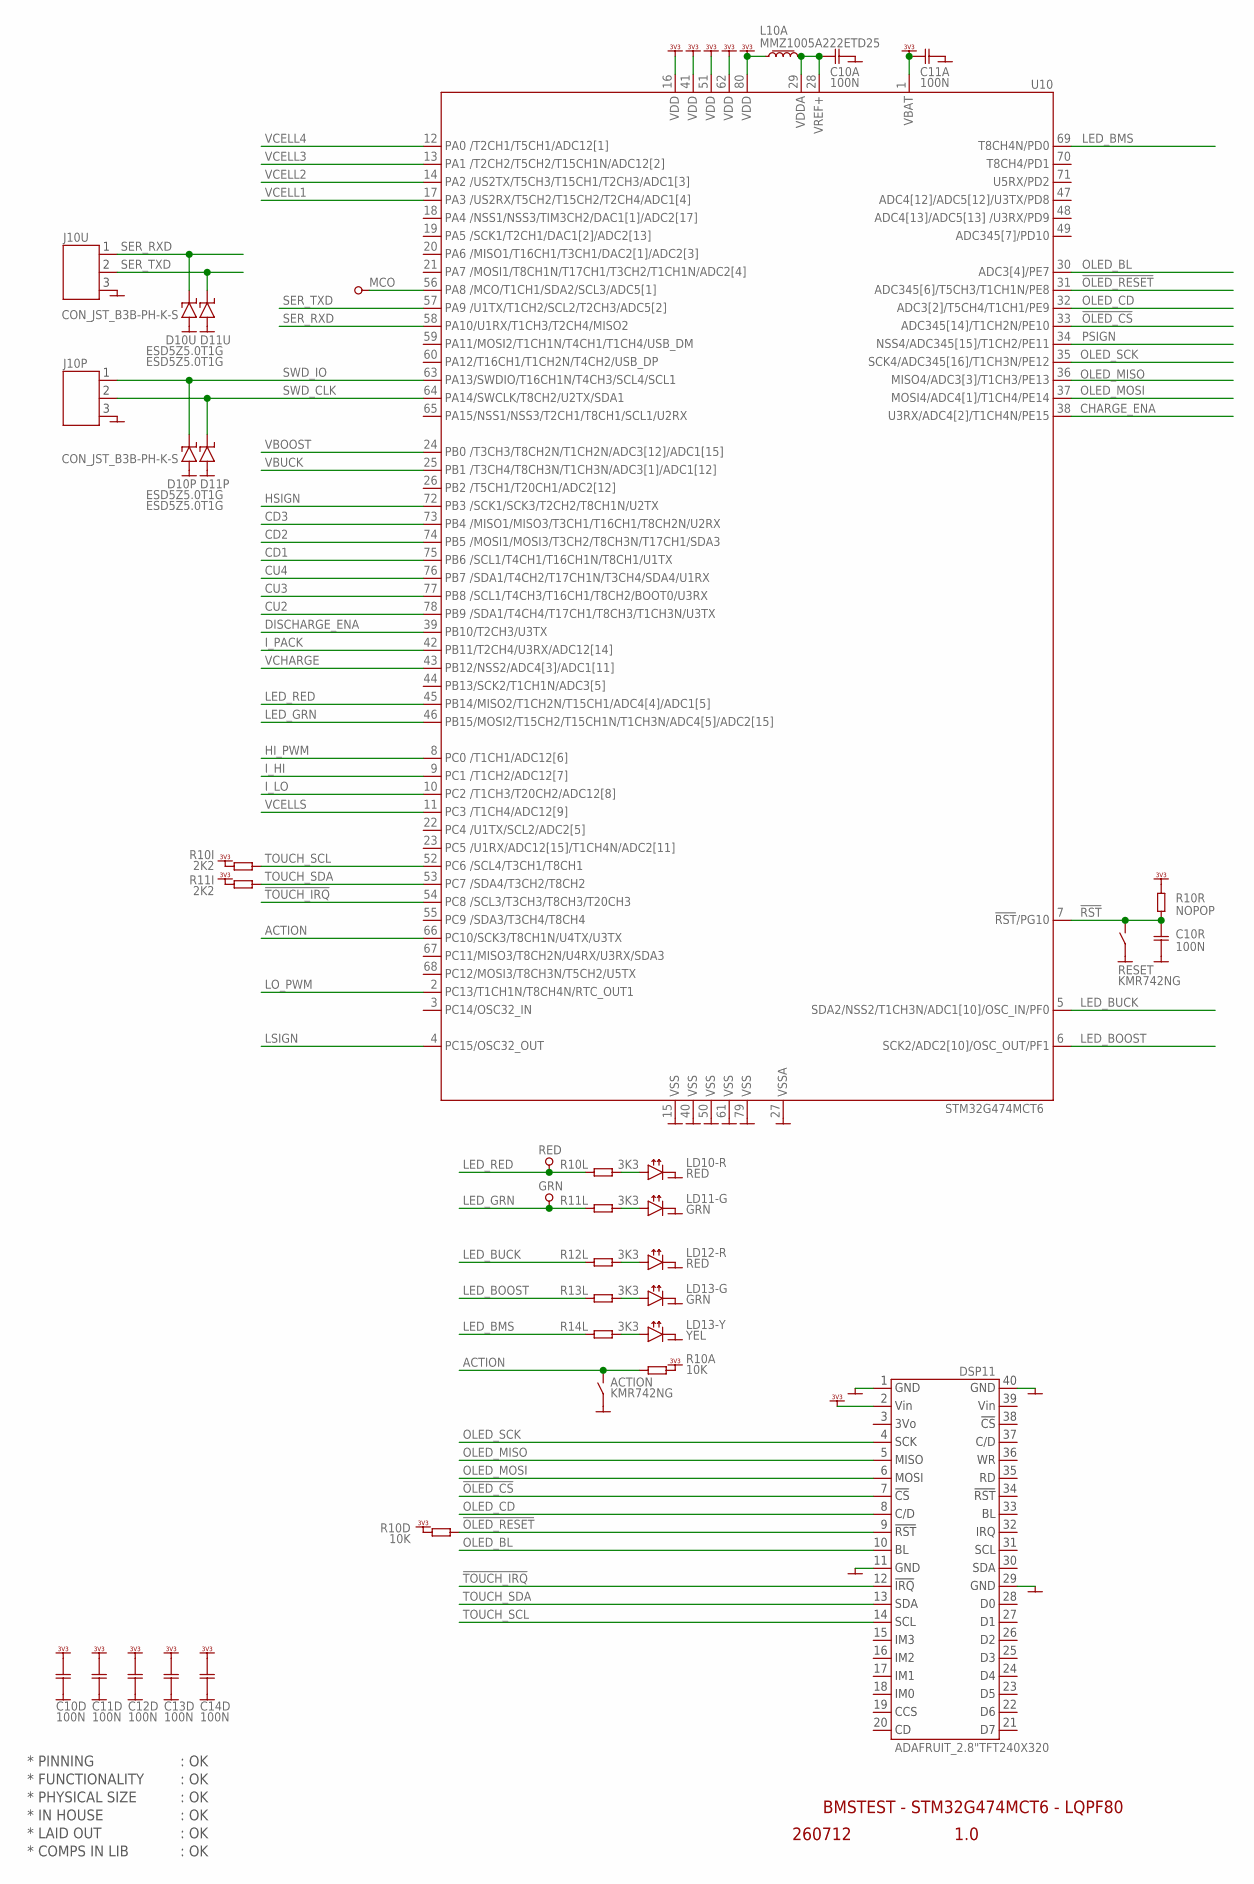
[picture p33: schematic BMSTEST-v1.1.sch, sheet 2]

Parts:
ACTION: KMR742NG; SWITCH_PUSHBUTTON_KMR742NG
C10A, C10D, C11A, C11D, C12D, C13D, C14D: 100N; CAP0402
C10R: 100N; CAP0603
D10P, D10U, D11P, D11U: ESD5Z5.0T1G; DIODE_SOD523
DSP11: ADAFRUIT_2.8"TFT240X320
GRN: PIN_TEST; HOLE_PTH_0.8MM
J10P, J10U: CON_JST_B3B-PH-K-S
L10A: MMZ1005A222ETD25; L_0402
LD10-R, LD12-R: RED; LED_SMD_0603
LD11-G, LD13-G: GRN; LED_SMD_0603
LD13-Y: YEL; LED_SMD_0603
MCO: PIN_TEST; HOLE_PTH_0.8MM
R10A, R10D: 10K; RES0603
R10I, R11I: 2K2; RES0402
R10L, R11L, R12L, R13L, R14L: 3K3; RES0603
R10R: NOPOP; RES0603
RED: PIN_TEST; HOLE_PTH_0.8MM
RESET: KMR742NG; SWITCH_PUSHBUTTON_KMR742NG
U10: STM32G474MCT6; LQFP80

Connections:
!OLED_CS: DSP11.7 (7.CS), U10.33 (33.PE10)
!OLED_RESET: DSP11.9 (9.!RST), R10D.2, U10.31 (31.PE8)
!RST: C10R.1, R10R.1, RESET.1, RESET.4 (1), U10.7 (7.!RST)
!TOUCH_IRQ: DSP11.12 (12.IRQ), U10.54 (54.PC8)
ACTION: ACTION.1, ACTION.4 (1), R10A.1, U10.66 (66.PC10)
CD1: U10.75 (75.PB6); also elsewhere on the board
CD2: U10.74 (74.PB5); also elsewhere on the board
CD3: U10.73 (73.PB4); also elsewhere on the board
CHARGE_ENA: U10.38 (38.PE15); also elsewhere on the board
CU2: U10.78 (78.PB9); also elsewhere on the board
CU3: U10.77 (77.PB8); also elsewhere on the board
CU4: U10.76 (76.PB7); also elsewhere on the board
DISCHARGE_ENA: U10.39 (39.PB10); also elsewhere on the board
GND: ACTION.2, ACTION.3 (2), C10A.2, C10D.2, C10R.2, C11A.2, C11D.2, C12D.2, C13D.2, C14D.2, D10P.A, D10U.A, D11P.A, D11U.A, DSP11.1 (1.GND), DSP11.11 (11.GND), DSP11.29 (29.GND), DSP11.40 (40.GND), J10P.3, J10U.3, LD10-R.C, LD11-G.C, LD12-R.C, LD13-G.C, LD13-Y.C, RESET.2, RESET.3 (2), U10.15 (15.VSS), U10.27 (27.VSSA), U10.40 (40.VSS), U10.50 (50.VSS), U10.61 (61.VSS), U10.79 (79.VSS); also elsewhere on the board
HI_PWM: U10.8 (8.PC0); also elsewhere on the board
HSIGN: U10.72 (72.PB3); also elsewhere on the board
I_HI: U10.9 (9.PC1); also elsewhere on the board
I_LO: U10.10 (10.PC2); also elsewhere on the board
I_PACK: U10.42 (42.PB11); also elsewhere on the board
LED_BMS: R14L.1, U10.69 (69.PD0)
LED_BOOST: R13L.1, U10.6 (6.OSC_OUT)
LED_BUCK: R12L.1, U10.5 (5.OSC_IN)
LED_GRN: GRN.1, R11L.1, U10.46 (46.PB15)
LED_RED: R10L.1, RED.1, U10.45 (45.PB14)
LO_PWM: U10.2 (2.PC13); also elsewhere on the board
LSIGN: U10.4 (4.PC15); also elsewhere on the board
MCO: MCO.1, U10.56 (56.PA8)
unnamed: LD13-Y.A, R14L.2
unnamed: LD11-G.A, R11L.2
unnamed: LD12-R.A, R12L.2
unnamed: LD13-G.A, R13L.2
unnamed: LD10-R.A, R10L.2
OLED_BL: DSP11.10 (10.BL), U10.30 (30.PE7)
OLED_CD: DSP11.8 (8.D/C), U10.32 (32.PE9)
OLED_MISO: DSP11.5 (5.MISO), U10.36 (36.PE13)
OLED_MOSI: DSP11.6 (6.MOSI), U10.37 (37.PE14)
OLED_SCK: DSP11.4 (4.SCK), U10.35 (35.PE12)
PSIGN: U10.34 (34.PE11); also elsewhere on the board
SER_RXD: D10U.C, J10U.1, U10.58 (58.PA10)
SER_TXD: D11U.C, J10U.2, U10.57 (57.PA9)
SWD_CLK: D11P.C, J10P.2, U10.64 (64.PA14)
SWD_IO: D10P.C, J10P.1, U10.63 (63.PA13)
TOUCH_SCL: DSP11.14 (14.SCL), R10I.1, U10.52 (52.PC6)
TOUCH_SDA: DSP11.13 (13.SDA), R11I.1, U10.53 (53.PC7)
VBOOST: U10.24 (24.PB0); also elsewhere on the board
VBUCK: U10.25 (25.PB1); also elsewhere on the board
VCELL1: U10.17 (17.PA3); also elsewhere on the board
VCELL2: U10.14 (14.PA2); also elsewhere on the board
VCELL3: U10.13 (13.PA1); also elsewhere on the board
VCELL4: U10.12 (12.PA0); also elsewhere on the board
VCELLS: U10.11 (11.PC3); also elsewhere on the board
VCHARGE: U10.43 (43.PB12); also elsewhere on the board
VDDA1: C10A.1, L10A.2, U10.28 (28.VREF+), U10.29 (29.VDDA)
VDD_3V3: C10D.1, C11A.1, C11D.1, C12D.1, C13D.1, C14D.1, DSP11.2 (2.VIN), L10A.1, R10A.2, R10D.1, R10I.2, R10R.2, R11I.2, U10.1 (1.VBAT), U10.16 (16.VDD), U10.41 (41.VDD), U10.51 (51.VDD), U10.62 (62.VDD), U10.80 (80.VDD); also elsewhere on the board

Notes on the sheet:
* PINNING
* FUNCTIONALITY
* PHYSICAL SIZE
* LAID OUT
* COMPS IN LIB
* IN HOUSE
BMSTEST - STM32G474MCT6 - LQPF80
260712
1.0
: OK

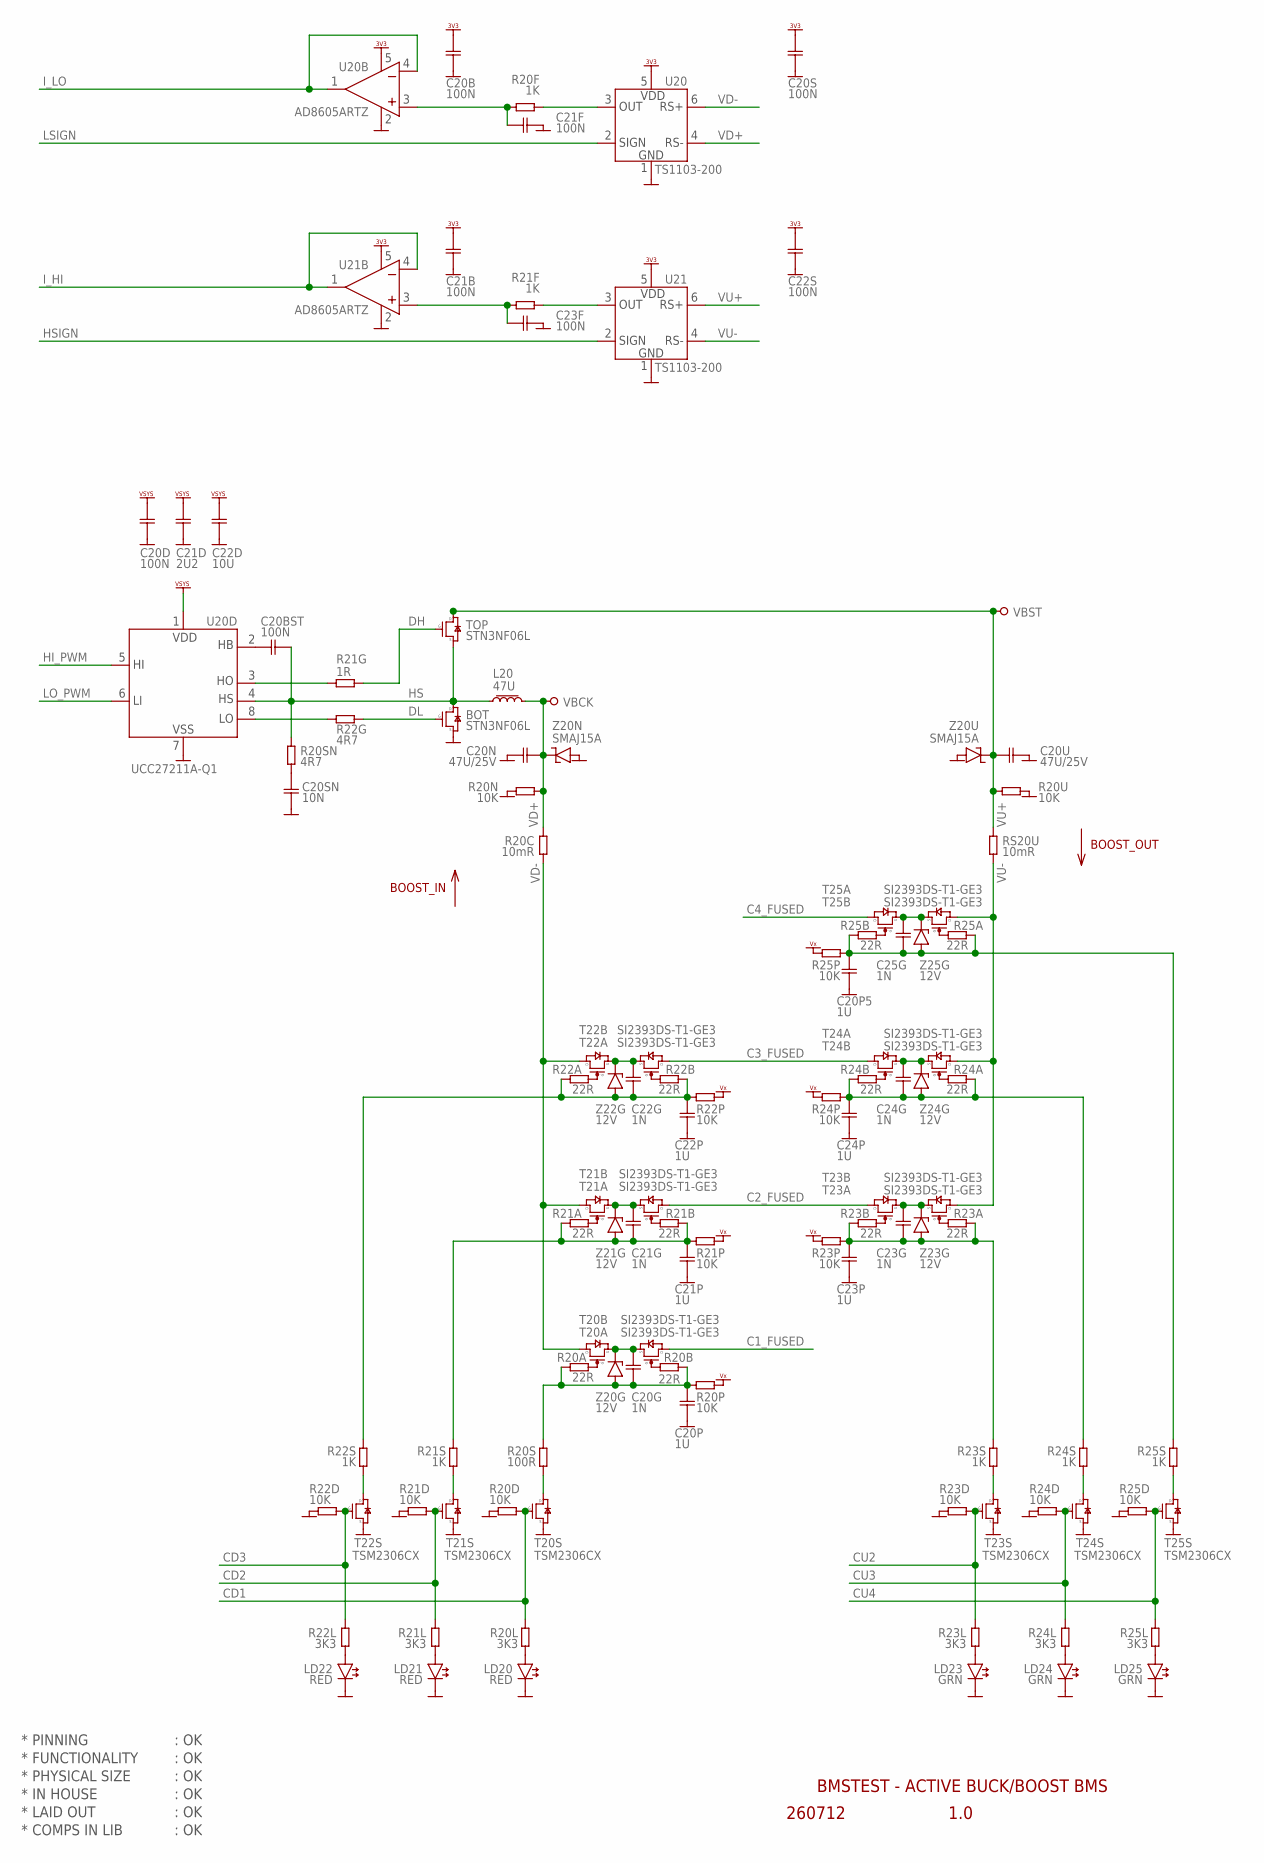
[picture p34: schematic BMSTEST-v1.1.sch, sheet 3]

Parts:
BOT: STN3NF06L; SOT223
C20B, C20D, C20S, C21B, C21F, C22S, C23F: 100N; CAP0603
C20BST: 100N; CAP0805
C20G, C21G, C22G, C23G, C24G, C25G: 1N; CAP0603
C20N, C20U: 47U/25V; CAP1210
C20P, C20P5, C21P, C22P, C23P, C24P: 1U; CAP0603
C20SN: 10N; CAP0805
C21D: 2U2; CAP0603
C22D: 10U; CAP0805
L20: 47U; L_WE_HCI_6.9X6.9
LD20, LD21, LD22: RED; LED_SMD_0603
LD23, LD24, LD25: GRN; LED_SMD_0603
R20A, R20B, R21A, R21B, R22A, R22B, R23A, R23B, R24A, R24B, R25A, R25B: 22R; RES0603
R20C: 10mR; RES1206
R20D, R20P, R21D, R21P, R22D, R22P, R23D, R23P, R24D, R24P, R25D, R25P: 10K; RES0603
R20F, R21F, R21S, R22S, R23S, R24S, R25S: 1K; RES0603
R20L, R21L, R22L, R23L, R24L, R25L: 3K3; RES0603
R20N, R20U: 10K; RES0805
R20S: 100R; RES0603
R20SN: 4R7; RES0805
R21G: 1R; RES0508
R22G: 4R7; RES0508
RS20U: 10mR; RES1206
T20A, T20B, T21A, T21B, T22A, T22B, T23A, T23B, T24A, T24B, T25A, T25B: SI2393DS-T1-GE3; PFET_SOT23
T20S, T21S, T22S, T23S, T24S, T25S: TSM2306CX; NFET_SOT23
TOP: STN3NF06L; SOT223
U20, U21: TS1103-200; SOT23-6
U20B, U21B: AD8605ARTZ; SOT23-5
U20D: UCC27211A-Q1; SO8-EP
VBCK: PIN_TEST; HOLE_PTH_0.8MM
VBST: PIN_TEST; HOLE_PTH_0.8MM
Z20G, Z21G, Z22G, Z23G, Z24G, Z25G: 12V; ZENER_SOD80
Z20N, Z20U: SMAJ15A; DIODE_SMA_UNI

Connections:
C1_FUSED: T20B.3 (D); also elsewhere on the board
C2_FUSED: T21B.3 (D), T23B.3 (D); also elsewhere on the board
C3_FUSED: T22B.3 (D), T24B.3 (D); also elsewhere on the board
C4_FUSED: T25B.3 (D); also elsewhere on the board
CD1: R20D.2, R20L.2, T20S.G (G1); also elsewhere on the board
CD2: R21D.2, R21L.2, T21S.G (G1); also elsewhere on the board
CD3: R22D.2, R22L.2, T22S.G (G1); also elsewhere on the board
CU2: R23D.2, R23L.2, T23S.G (G1); also elsewhere on the board
CU3: R24D.2, R24L.2, T24S.G (G1); also elsewhere on the board
CU4: R25D.2, R25L.2, T25S.G (G1); also elsewhere on the board
DH: R21G.2, TOP.1 (G)
DL: BOT.1 (G), R22G.2
G0: C20G.2, C20P.1, R20A.2, R20B.1, R20P.2, R20S.1, Z20G.1 (A)
G1: C21G.2, C21P.1, R21A.2, R21B.1, R21P.2, R21S.1, Z21G.1 (A)
G2: C22G.2, C22P.1, R22A.2, R22B.1, R22P.2, R22S.1, Z22G.1 (A)
G3: C23G.2, C23P.1, R23A.1, R23B.2, R23P.2, R23S.1, Z23G.1 (A)
G4: C24G.2, C24P.1, R24A.1, R24B.2, R24P.2, R24S.1, Z24G.1 (A)
G5: C20P5.1, C25G.2, R25A.1, R25B.2, R25P.2, R25S.1, Z25G.1 (A)
GND: BOT.3 (S), C20B.2, C20D.2, C20N.1, C20P.2, C20P5.2, C20S.2, C20SN.2, C20U.2, C21B.2, C21D.2, C21F.1, C21P.2, C22D.2, C22P.2, C22S.2, C23F.1, C23P.2, C24P.2, LD20.C, LD21.C, LD22.C, LD23.C, LD24.C, LD25.C, R20D.1, R20N.2, R20U.2, R21D.1, R22D.1, R23D.1, R24D.1, R25D.1, T20S.S (S2), T21S.S (S2), T22S.S (S2), T23S.S (S2), T24S.S (S2), T25S.S (S2), U20.1 (1.GND), U20B.2 (2.V-), U20D.7 (7.VSS), U20D.EP (7.VSS), U21.1 (1.GND), U21B.2 (2.V-), Z20N.2 (A), Z20U.2 (A); also elsewhere on the board
HB: C20BST.1, U20D.2 (2.HB)
HI_PWM: U20D.5 (5.HI); also elsewhere on the board
HO: R21G.1, U20D.3 (3.HO)
HS: BOT.2 (D), BOT.4 (D1), C20BST.2, L20.1, R20SN.1, TOP.3 (S), U20D.4 (4.HS)
HSIGN: U21.2 (2.SIGN); also elsewhere on the board
I_HI: U21B.1 (1.OUT), U21B.4 (4.IN-); also elsewhere on the board
I_HI*: C23F.2, R21F.2, U21B.3 (3.IN+)
I_LO: U20B.1 (1.OUT), U20B.4 (4.IN-); also elsewhere on the board
I_LO*: C21F.2, R20F.2, U20B.3 (3.IN+)
LO: R22G.1, U20D.8 (8.LO)
LO_PWM: U20D.6 (6.LI); also elsewhere on the board
LSIGN: U20.2 (2.SIGN); also elsewhere on the board
unnamed: LD22.A, R22L.1
unnamed: LD21.A, R21L.1
unnamed: R23B.1, T23B.1 (G)
unnamed: LD20.A, R20L.1
unnamed: R24B.1, T24B.1 (G)
unnamed: R21A.1, T21A.1 (G)
unnamed: R21B.2, T21B.1 (G)
unnamed: R20A.1, T20A.1 (G)
unnamed: R22B.2, T22B.1 (G)
unnamed: R20B.2, T20B.1 (G)
unnamed: R22A.1, T22A.1 (G)
unnamed: R23A.2, T23A.1 (G)
unnamed: R25B.1, T25B.1 (G)
unnamed: R24A.2, T24A.1 (G)
unnamed: R22S.2, T22S.D (D3)
unnamed: R21S.2, T21S.D (D3)
unnamed: R20S.2, T20S.D (D3)
unnamed: R25A.2, T25A.1 (G)
unnamed: R23S.2, T23S.D (D3)
unnamed: R24S.2, T24S.D (D3)
unnamed: C20SN.1, R20SN.2
unnamed: R25S.2, T25S.D (D3)
unnamed: LD23.A, R23L.1
unnamed: LD24.A, R24L.1
unnamed: LD25.A, R25L.1
unnamed: R20F.1, U20.3 (3.OUT)
unnamed: R21F.1, U21.3 (3.OUT)
S0: C20G.1, T20A.2 (S), T20B.2 (S), Z20G.2 (C)
S1: C21G.1, T21A.2 (S), T21B.2 (S), Z21G.2 (C)
S2: C22G.1, T22A.2 (S), T22B.2 (S), Z22G.2 (C)
S3: C23G.1, T23A.2 (S), T23B.2 (S), Z23G.2 (C)
S4: C24G.1, T24A.2 (S), T24B.2 (S), Z24G.2 (C)
S5: C25G.1, T25A.2 (S), T25B.2 (S), Z25G.2 (C)
VD+: C20N.2, L20.2, R20C.1, R20N.1, U20.4 (4.RS-), VBCK.1, Z20N.1 (C); also elsewhere on the board
VD-: R20C.2, T20A.3 (D), T21A.3 (D), T22A.3 (D), U20.6 (6.RS+)
VDD_3V3: C20B.1, C20S.1, C21B.1, C22S.1, U20.5 (5.VDD), U20B.5 (5.V+), U21.5 (5.VDD), U21B.5 (5.V+); also elsewhere on the board
VSYS: C20D.1, C21D.1, C22D.1, U20D.1 (1.VDD); also elsewhere on the board
VU+: C20U.1, R20U.1, RS20U.1, TOP.2 (D), TOP.4 (D1), U21.6 (6.RS+), VBST.1, Z20U.1 (C); also elsewhere on the board
VU-: RS20U.2, T23A.3 (D), T24A.3 (D), T25A.3 (D), U21.4 (4.RS-)
VX: R20P.1, R21P.1, R22P.1, R23P.1, R24P.1, R25P.1; also elsewhere on the board

Notes on the sheet:
* PINNING
* FUNCTIONALITY
* PHYSICAL SIZE
* LAID OUT
* COMPS IN LIB
* IN HOUSE
BMSTEST - ACTIVE BUCK/BOOST BMS
260712
1.0
: OK
BOOST_OUT
BOOST_IN

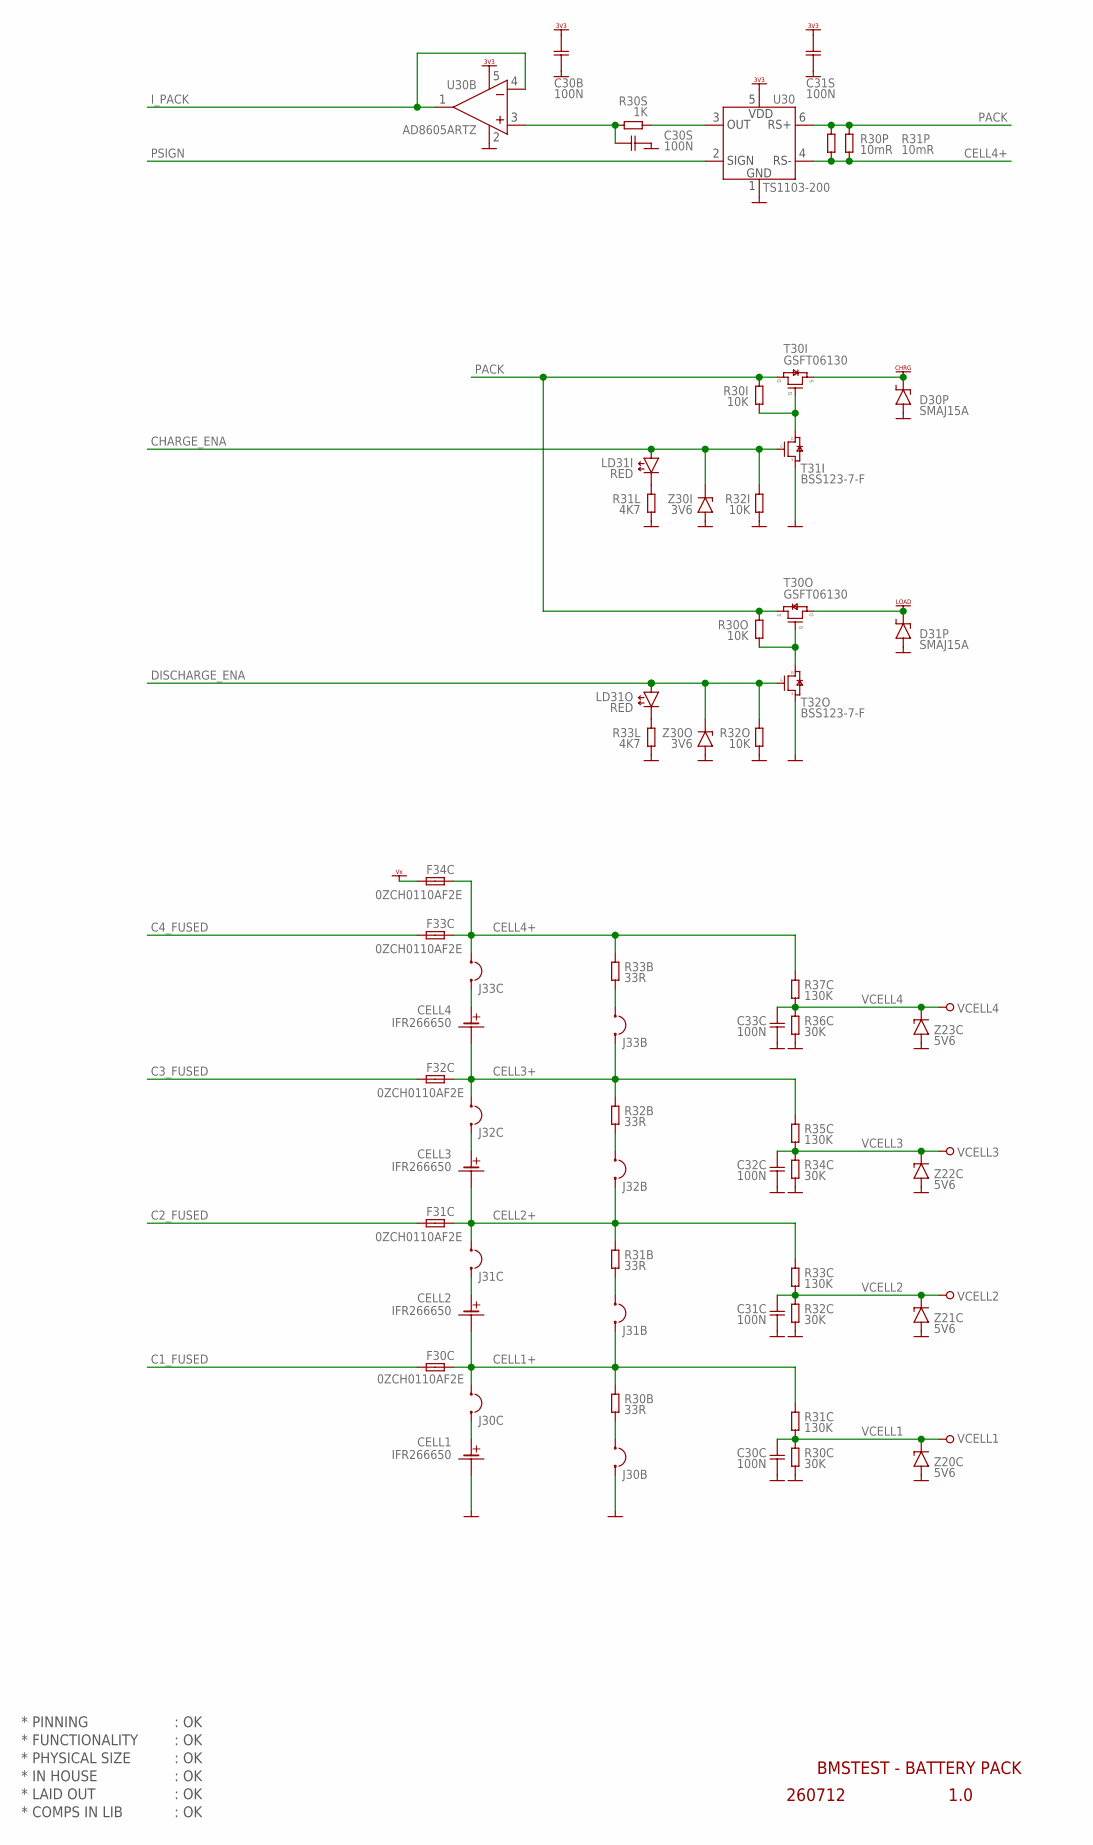
[picture p35: schematic BMSTEST-v1.1.sch, sheet 4]

Parts:
C30B, C30S, C31S: 100N; CAP0603
C30C, C31C, C32C, C33C: 100N; CAP0805
CELL1, CELL2, CELL3, CELL4: IFR266650; BATTERY_HOLDER_26650
D30P, D31P: SMAJ15A; DIODE_SMA_UNI
F30C, F31C, F32C, F33C, F34C: 0ZCH0110AF2E; POLYFUSE1210
J30B, J30C, J31B, J31C, J32B, J32C, J33B, J33C: GOLD2
LD31I, LD31O: RED; LED_SMD_0603
R30B, R31B, R32B, R33B: 33R; RES1210
R30C, R32C, R34C, R36C: 30K; RES0805
R30I, R30O, R32I, R32O: 10K; RES0603
R30P, R31P: 10mR; RES1206
R30S: 1K; RES0603
R31C, R33C, R35C, R37C: 130K; RES0805
R31L, R33L: 4K7; RES0603
T30I, T30O: GSFT06130; D2PAK
T31I, T32O: BSS123-7-F; NFET_SOT23
U30: TS1103-200; SOT23-6
U30B: AD8605ARTZ; SOT23-5
VCELL1, VCELL2, VCELL3, VCELL4: PIN_TEST; HOLE_PTH_0.8MM
Z20C, Z21C, Z22C, Z23C: 5V6; ZENER_SOD80
Z30I, Z30O: 3V6; ZENER_SOD80

Connections:
!IN_ON: R30I.2, T30I.1 (G), T31I.D (D3)
!OUT_ON: R30O.2, T30O.1 (G), T32O.D (D3)
C1+: CELL1.+ (1), J30C.1
C1_FUSED: F30C.2; also elsewhere on the board
C2+: CELL2.+ (1), J31C.1
C2_FUSED: F31C.2; also elsewhere on the board
C3+: CELL3.+ (1), J32C.1
C3_FUSED: F32C.2; also elsewhere on the board
C4+: CELL4.+ (1), J33C.1
C4_FUSED: F33C.2; also elsewhere on the board
CELL1+: CELL2.- (2), F30C.1, J30C.2, J31B.1, R30B.2, R31C.1
CELL2+: CELL3.- (2), F31C.1, J31C.2, J32B.1, R31B.2, R33C.1
CELL3+: CELL4.- (2), F32C.1, J32C.2, J33B.1, R32B.2, R35C.1
CELL4+: F33C.1, F34C.1, J33C.2, R30P.2, R31P.2, R33B.2, R37C.1, U30.4 (4.RS-); also elsewhere on the board
CHARGE_ENA: LD31I.A, R32I.1, T31I.G (G1), Z30I.2 (C); also elsewhere on the board
DISCHARGE_ENA: LD31O.A, R32O.1, T32O.G (G1), Z30O.2 (C); also elsewhere on the board
GND: C30B.2, C30C.2, C30S.1, C31C.2, C31S.2, C32C.2, C33C.2, CELL1.- (2), D30P.2 (A), D31P.2 (A), J30B.1, R30C.2, R31L.2, R32C.2, R32I.2, R32O.2, R33L.2, R34C.2, R36C.2, T31I.S (S2), T32O.S (S2), U30.1 (1.GND), U30B.2 (2.V-), Z20C.1 (A), Z21C.1 (A), Z22C.1 (A), Z23C.1 (A), Z30I.1 (A), Z30O.1 (A); also elsewhere on the board
I_LO*1: C30S.2, R30S.2, U30B.3 (3.IN+)
I_PACK: U30B.1 (1.OUT), U30B.4 (4.IN-); also elsewhere on the board
unnamed: R30S.1, U30.3 (3.OUT)
unnamed: LD31I.C, R31L.1
unnamed: LD31O.C, R33L.1
unnamed: J30B.2, R30B.1
unnamed: J31B.2, R31B.1
unnamed: J32B.2, R32B.1
unnamed: J33B.2, R33B.1
PACK: R30I.1, R30O.1, R30P.1, R31P.1, T30I.3 (D), T30O.2 (S), U30.6 (6.RS+)
PSIGN: U30.2 (2.SIGN); also elsewhere on the board
VCELL1: C30C.1, R30C.1, R31C.2, VCELL1.1, Z20C.2 (C); also elsewhere on the board
VCELL2: C31C.1, R32C.1, R33C.2, VCELL2.1, Z21C.2 (C); also elsewhere on the board
VCELL3: C32C.1, R34C.1, R35C.2, VCELL3.1, Z22C.2 (C); also elsewhere on the board
VCELL4: C33C.1, R36C.1, R37C.2, VCELL4.1, Z23C.2 (C); also elsewhere on the board
VDD_3V3: C30B.1, C31S.1, U30.5 (5.VDD), U30B.5 (5.V+); also elsewhere on the board
VX: F34C.2; also elsewhere on the board
V_CHARGER: D30P.1 (C), T30I.2 (S); also elsewhere on the board
V_LOAD: D31P.1 (C), T30O.3 (D); also elsewhere on the board

Notes on the sheet:
* PINNING
* FUNCTIONALITY
* PHYSICAL SIZE
* LAID OUT
* COMPS IN LIB
* IN HOUSE
BMSTEST - BATTERY PACK
260712
1.0
: OK

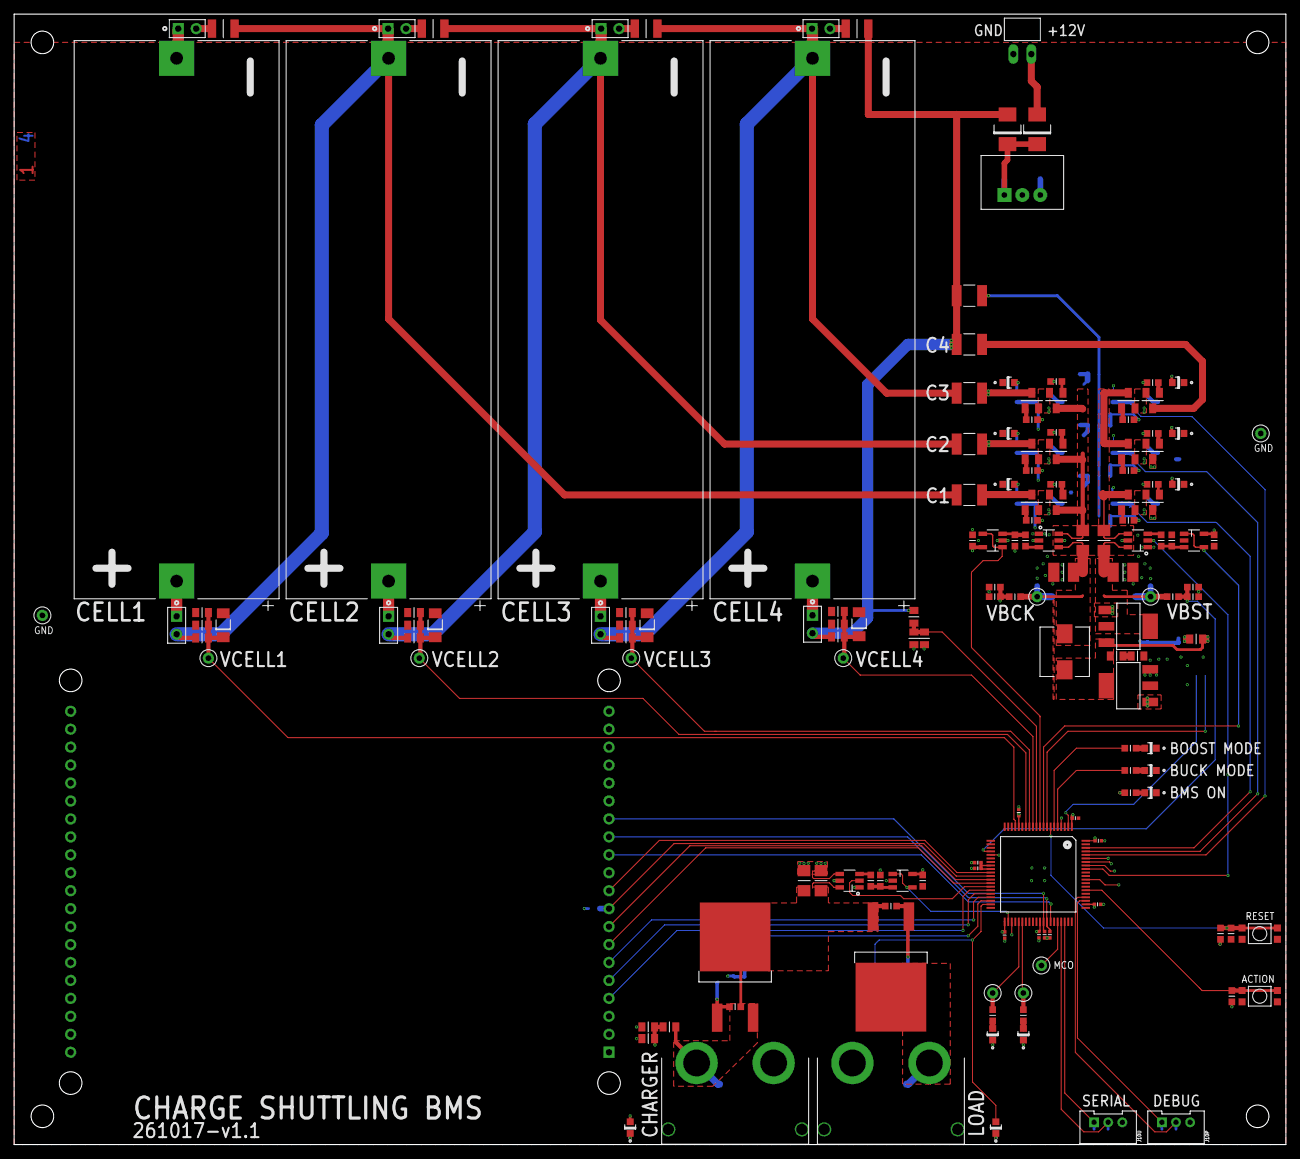
[picture p36: board BMSTEST-v1.1.brd from above]

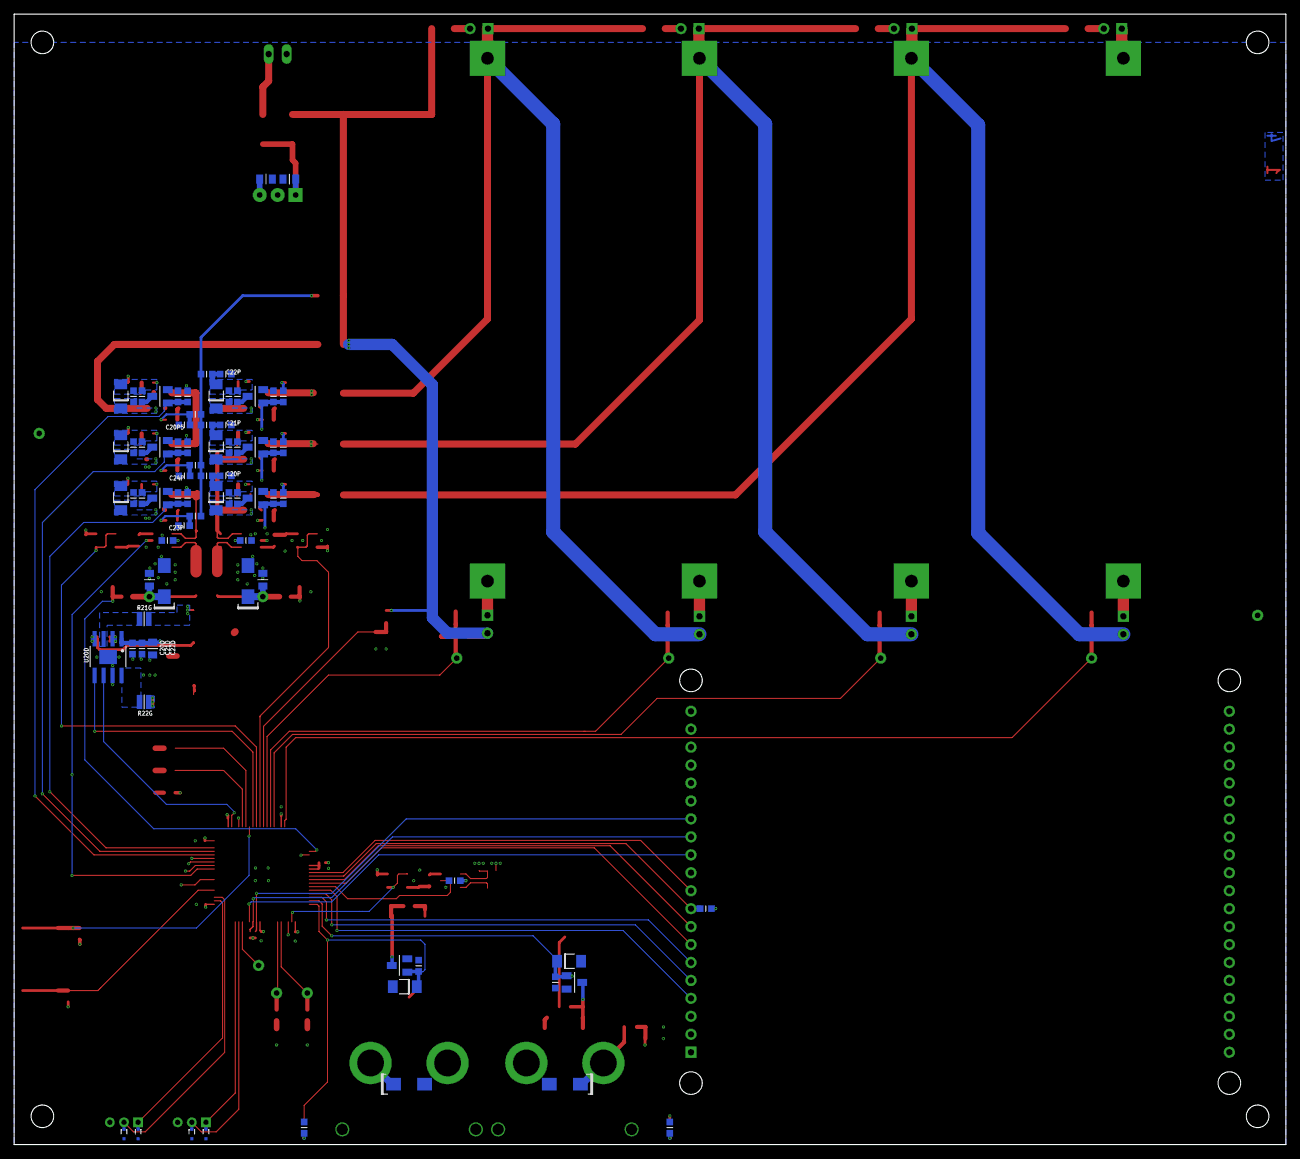
[picture p37: board BMSTEST-v1.1.brd from below]

Board: 4 copper layers, 180.0 x 160.0 mm, 240 parts (78 on the bottom side), 133 nets.
